rimopu10/carro/render/salida/modelo-completo.png

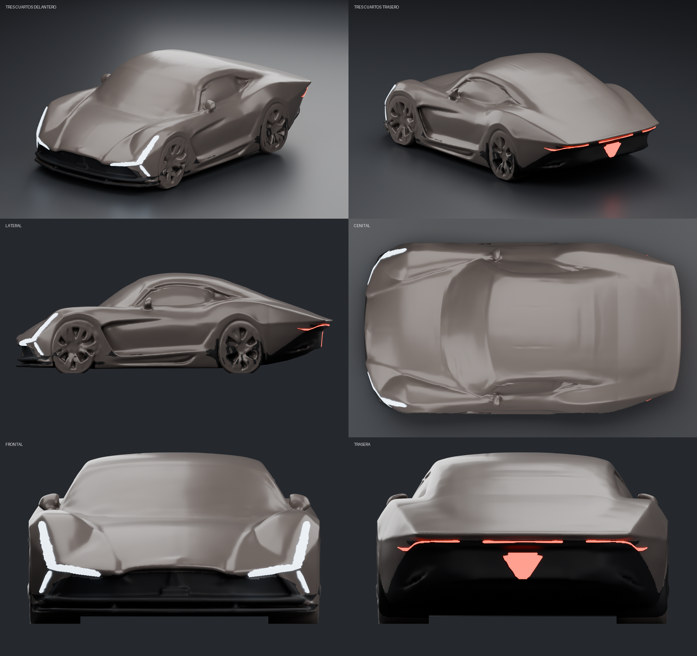
render/salida/modelo-completo.png
