rimopu10/carro/docs/auditoria-cabina/vista-ojos-piloto.png

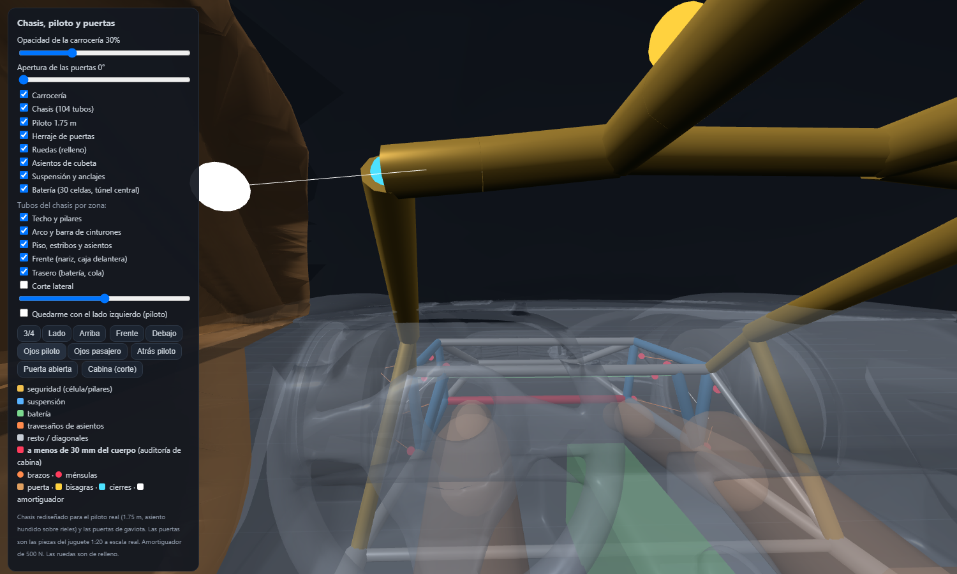
docs/auditoria-cabina/vista-ojos-piloto.png
