rimopu10/carro/docs/espacios-y-cajuela.md

# Espacios libres: frunk, bandeja y maletero

Calculado con `calculos/espacios_libres.py`: interior de la piel de Tripo (cascarón de 12 mm + 20 mm de holgura) menos tubos del chasis, ruedas con su recorrido, brazos,
amortiguadores, cremallera, columna de dirección, pies y piernas de piloto y pasajero, la pila de la batería y la electrónica trasera. Cajas simétricas respecto a z=0.
Los tres espacios se ven en `carro-tripo-chasis-3d.html` (interruptor «Espacios»).

| Espacio | Caja libre | Volumen | Acceso |
|---|---|---|---|
| **Frunk de la nariz** | x 0.00–0.30, y 0.35–0.55, z ±0.30 (0.30 × 0.60 × 0.20 m) | **36 L** | cofre |
| **Bandeja bajo el cofre**, sobre la caja delantera | x 0.36–0.96, y 0.50–0.65, z ±0.25 (0.60 × 0.50 × 0.15 m) | **45 L** | cofre |
| **Maletero** detrás del arco, sobre la electrónica | x 2.24–2.74, y 0.40–0.90, z ±0.35 (0.50 × 0.70 × 0.50 m) | **175 L** | clamshell trasero |
| Hueco bajo el tablero entre las piernas | x 0.50–1.00, y 0.10–0.45, z ±0.20 | 70 L | sólo desde la cabina: no se usa |

**Por qué lo de adelante es chico:** el eje delantero está a 0.55 m de la punta (voladizo corto), las torres de suspensión, la cremallera y la pedalera ocupan la caja entre el
mamparo y el tablero, y el cono de la nariz es la zona de deformación. No es espacio desperdiciado: es el precio de un carro de 2.13 m de batalla con motor y batería
al centro-atrás. El grueso de la carga va **atrás**.

## Reparto propuesto (estilo Porsche: servicios adelante, equipaje atrás)
**Frunk de la nariz (36 L):** depósito del lavaparabrisas (3–4 L), toma de carga con su cable (~3 L), compresor de aire y kit de pinchazo, banda de remolque. Objetos ligeros:
es la zona de deformación, no se pone nada pesado ni rígido.
**Bandeja bajo el cofre (45 L, plana de 15 cm):** motor y varillaje de limpiaparabrisas (junto al cowl, x≈0.95), depósitos de líquido de frenos (junto a los cilindros del pedal),
triángulo de emergencia, botiquín, herramienta. Todo atornillado a una charola de aluminio con tapa de servicio.
**Maletero (175 L):** equipaje (dos maletas de cabina), cascos, gatos. Queda sobre la electrónica de potencia (y < 0.40), con piso de aluminio y una división contra los cables.

Masa de estos servicios ≈ 12 kg (agua 4, cable y compresor 5, herramienta 3): efecto en el reparto despreciable (<0.2 puntos).

## Pendiente
* Dibujar la tapa del cofre y sus bisagras (hoy el cofre es piel fija en el modelo) y el clamshell trasero.
* Revisar con el proveedor el tamaño real del depósito y del motor del limpiaparabrisas.
* Si se quiere más frunk: un carro con el voladizo delantero 10 cm más largo daría ~+25 L; no se recomienda sin rehacer la carrocería de Tripo.
