rimopu10/carro/calculos/carro3d-jaula.png

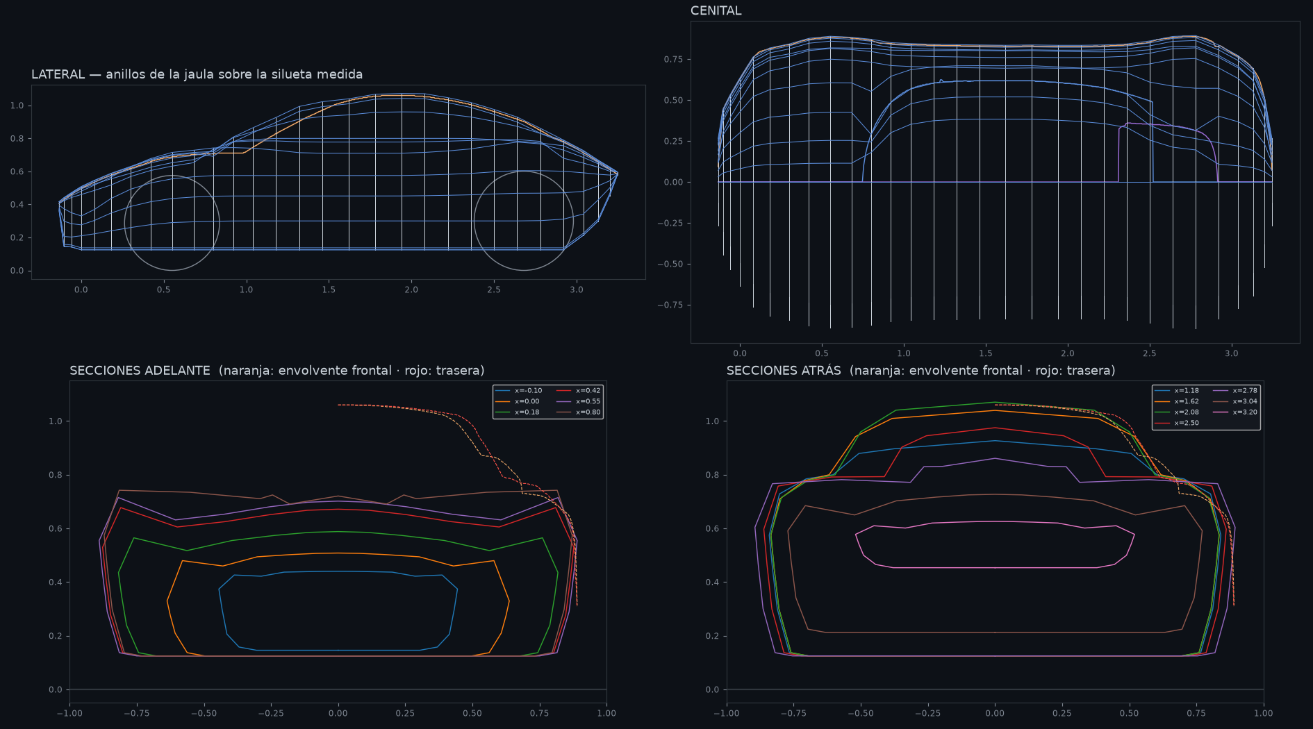
calculos/carro3d-jaula.png
