rimopu10/carro/calculos/carroceria-proporciones.png

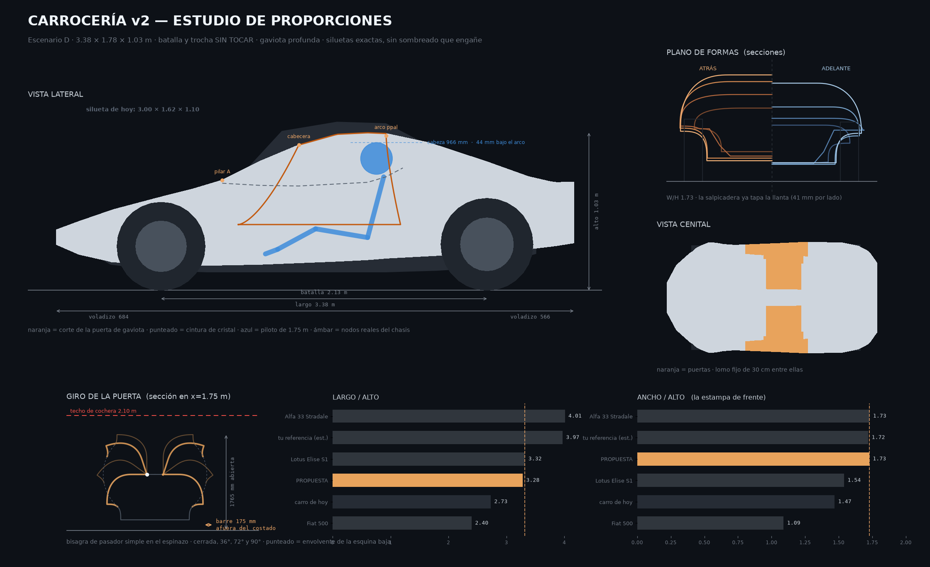
calculos/carroceria-proporciones.png
