rimopu10/carro/calculos/chasis-generativo-vs-tubos.png

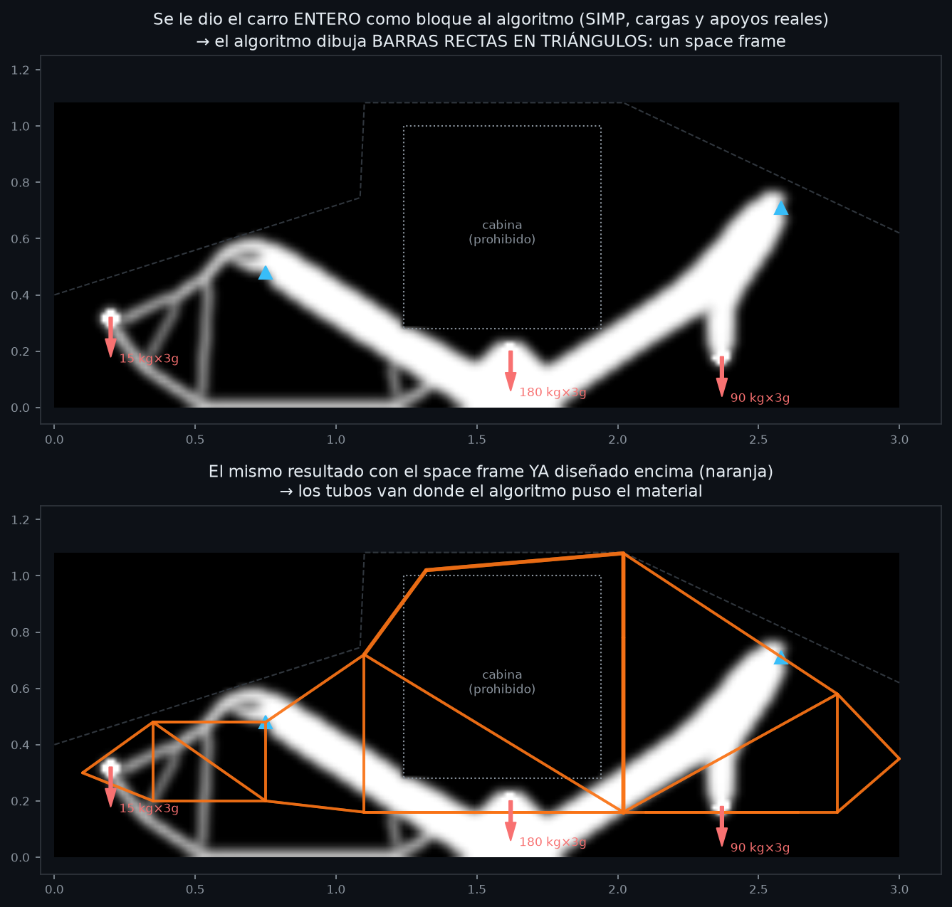
calculos/chasis-generativo-vs-tubos.png
