rimopu10/carro/calculos/direccion.png

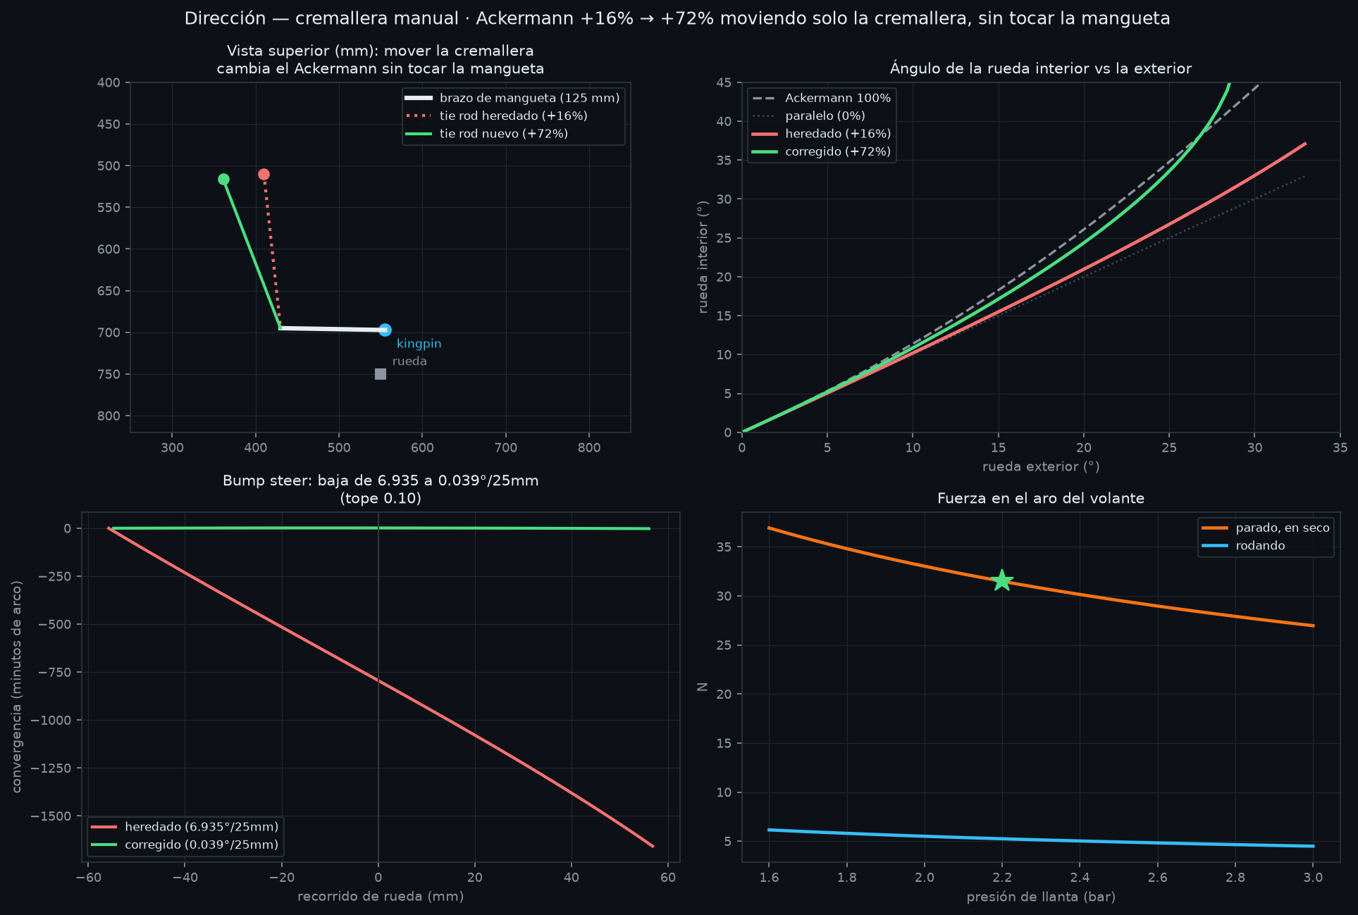
calculos/direccion.png
