rimopu10/carro/calculos/frenos.png

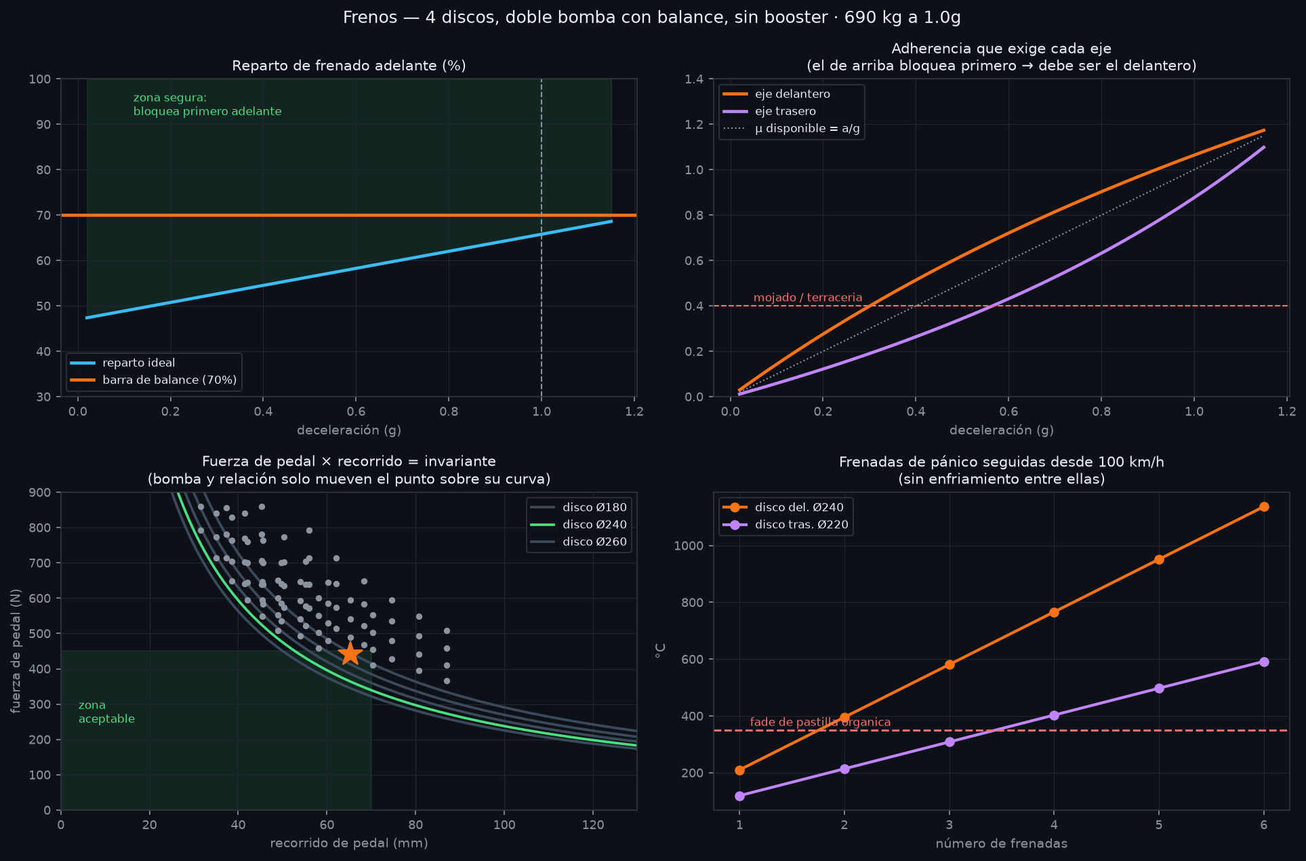
calculos/frenos.png
