rimopu10/carro/calculos/optimizacion-chasis.png

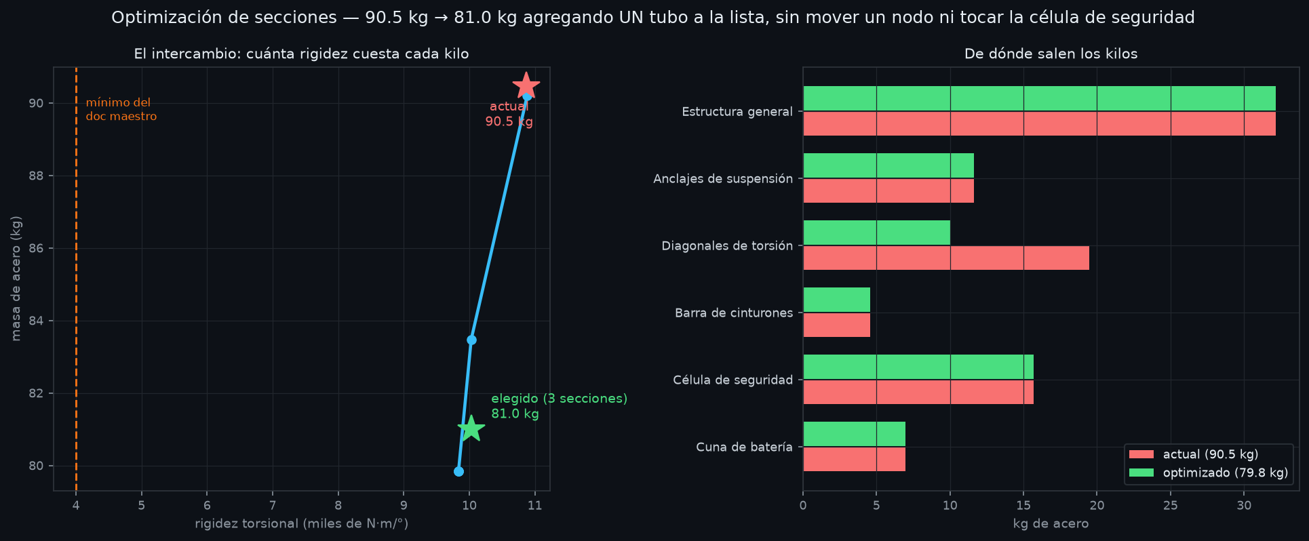
calculos/optimizacion-chasis.png
