rimopu10/carro/calculos/placa-torque.png

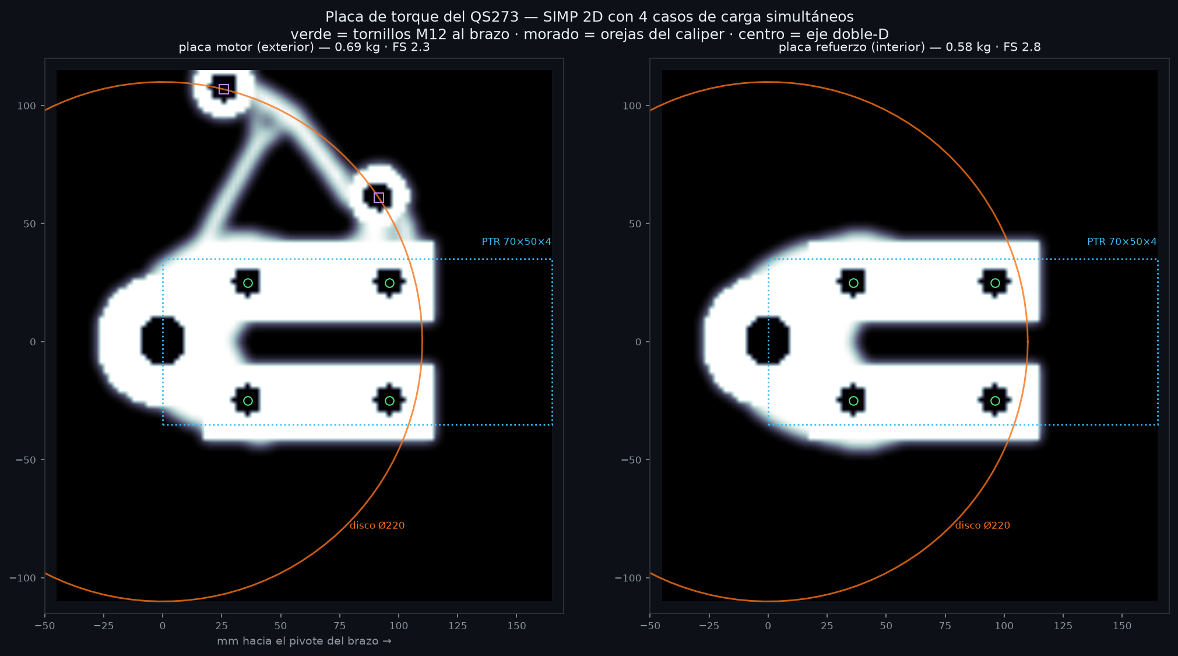
calculos/placa-torque.png
