rimopu10/carro/calculos/suspension-delantera.png

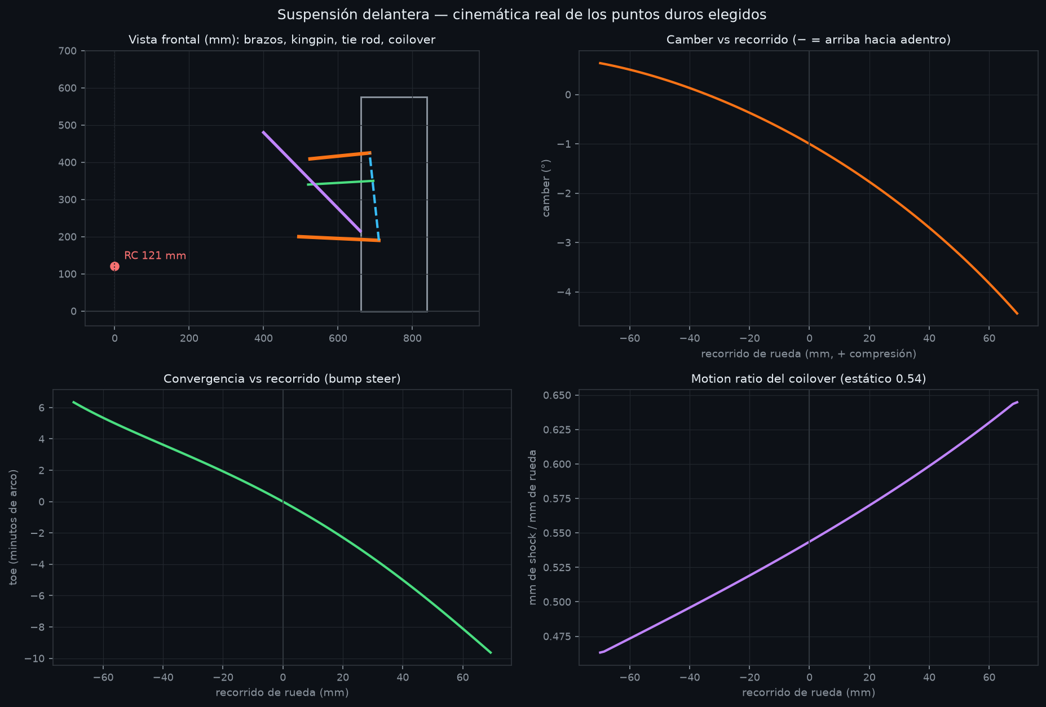
calculos/suspension-delantera.png
