rimopu10/carro/calculos/suspension-trasera.png

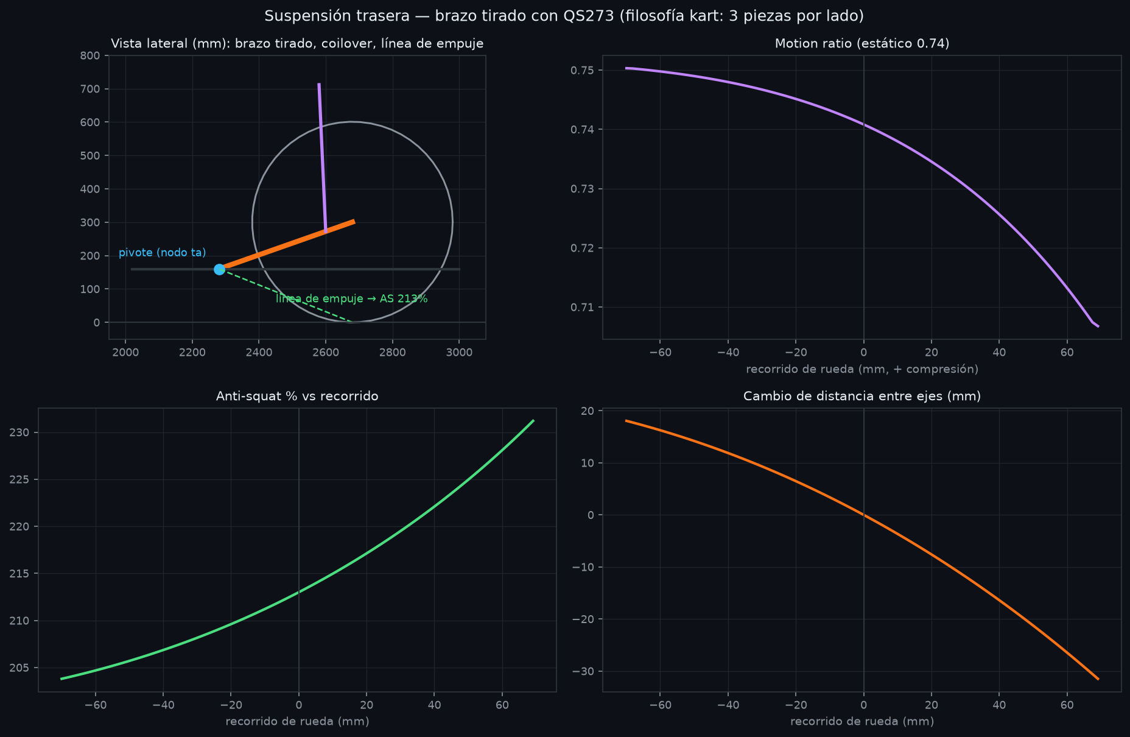
calculos/suspension-trasera.png
