rimopu10/carro/docs/auditoria-cabina/cabina-tubos-vs-cuerpo.png

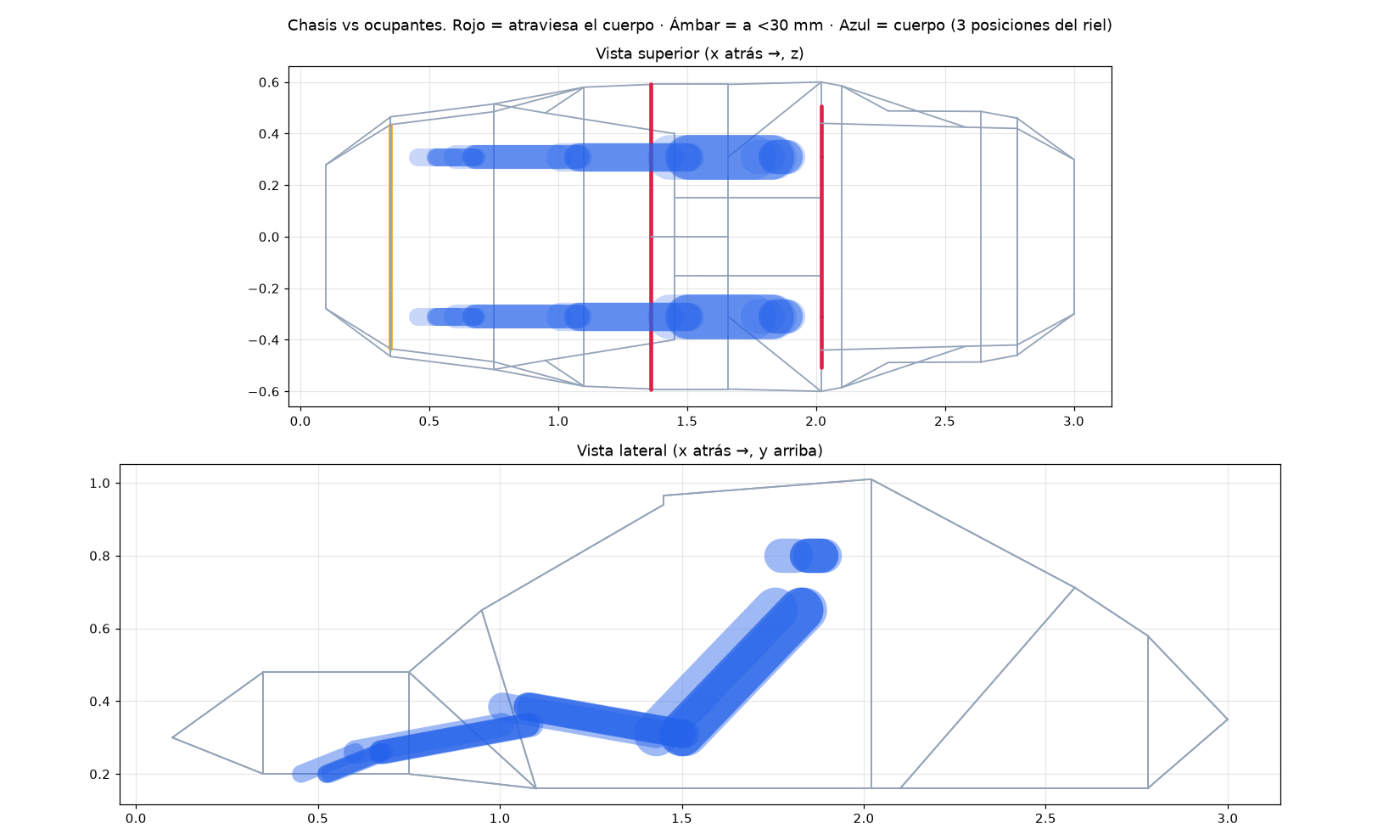
docs/auditoria-cabina/cabina-tubos-vs-cuerpo.png
