rimopu10/carro/docs/auditoria-cabina/vista-arriba-sin-techo.png

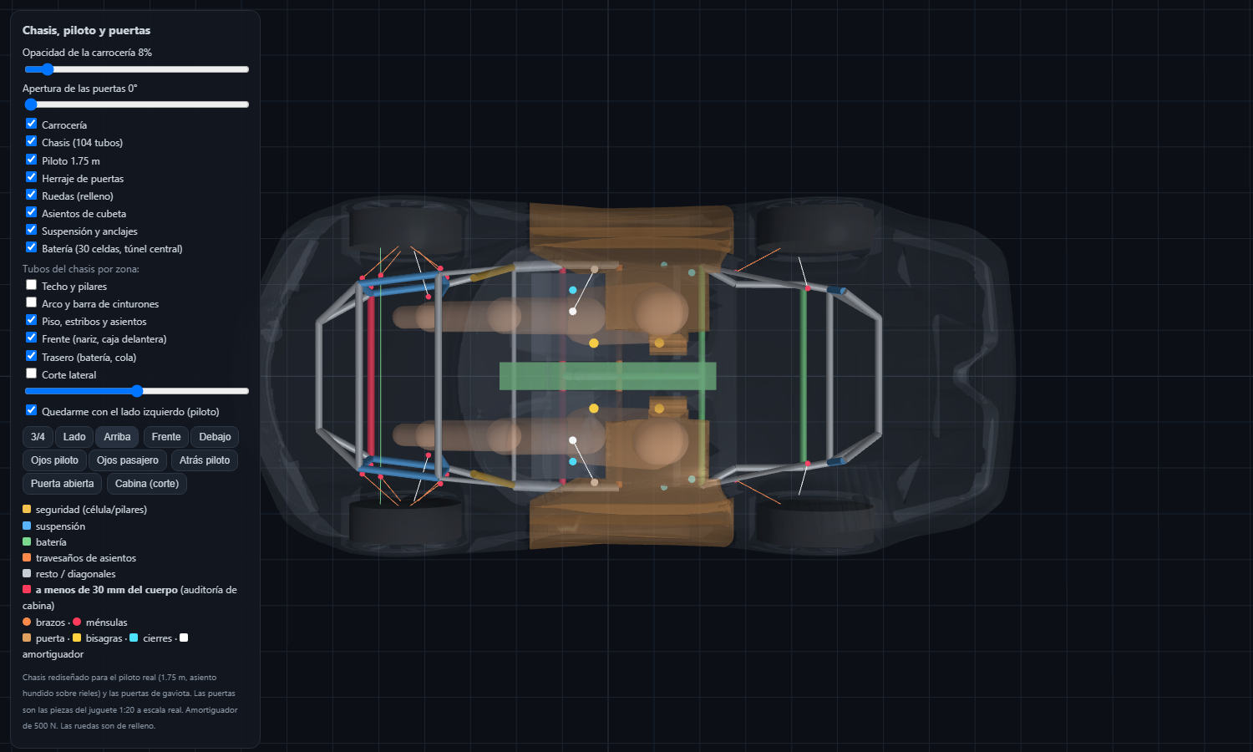
docs/auditoria-cabina/vista-arriba-sin-techo.png
