rimopu10/carro/docs/auditoria-cabina/vista-cabina-corte.png

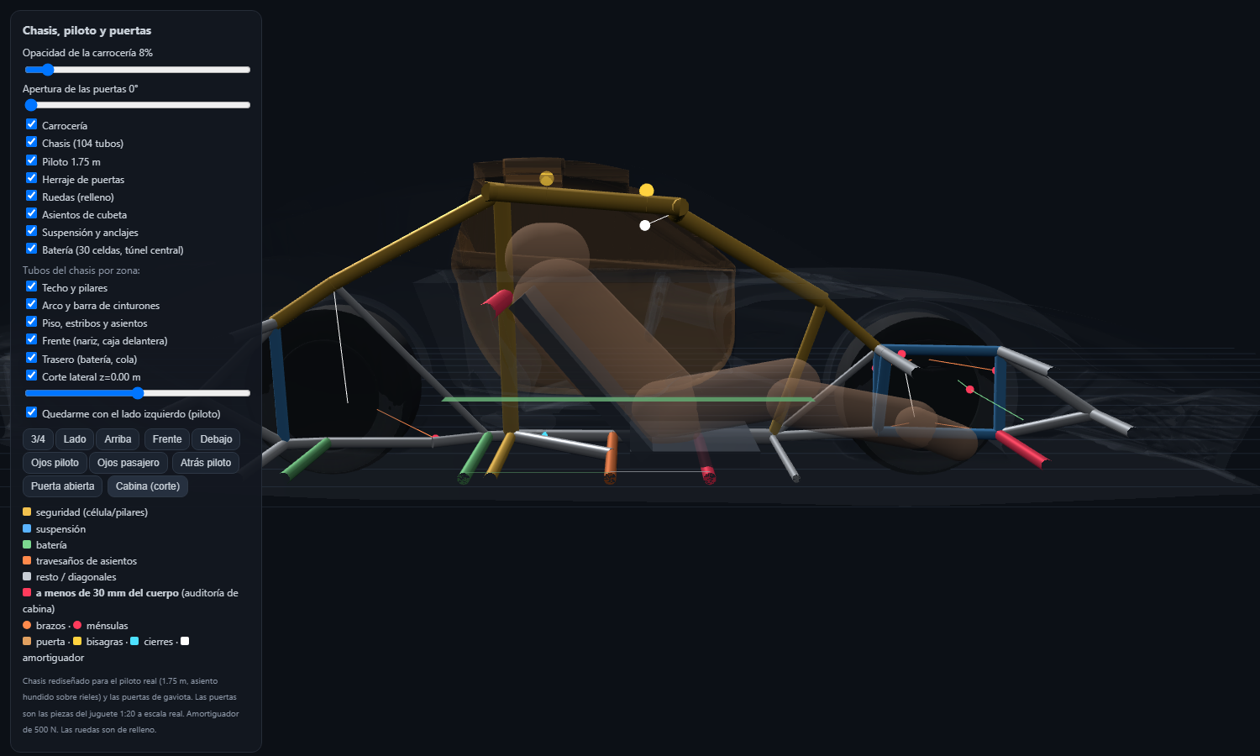
docs/auditoria-cabina/vista-cabina-corte.png
