rimopu10/carro/docs/auditoria-cabina/vista-espacios-lado.png

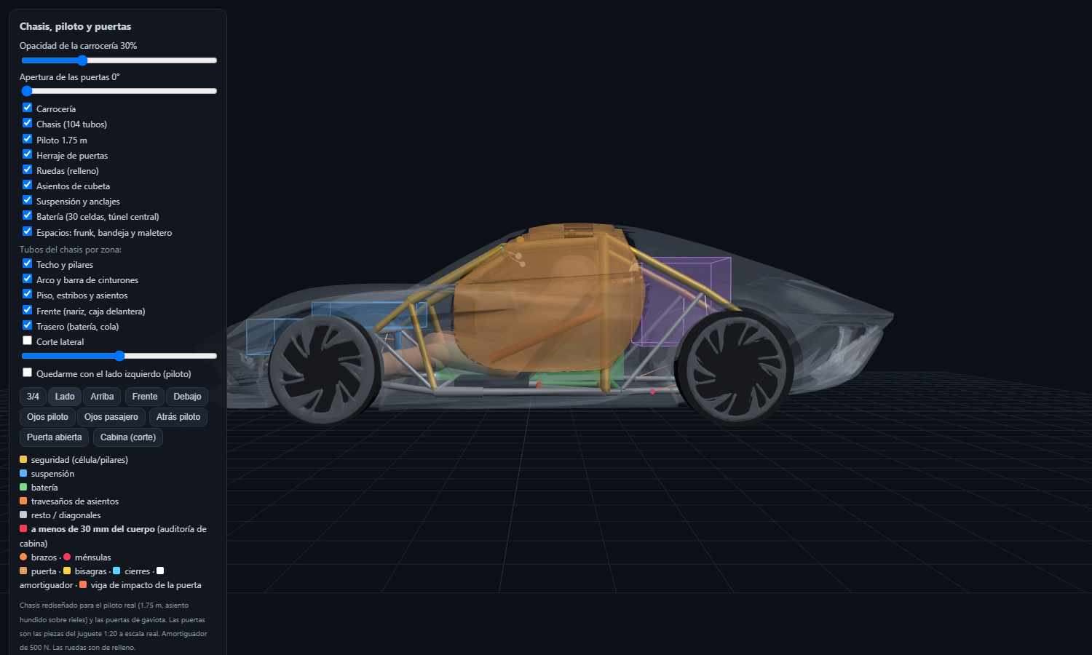
docs/auditoria-cabina/vista-espacios-lado.png
