rimopu10/carro/docs/auditoria-cabina/vista-general.png

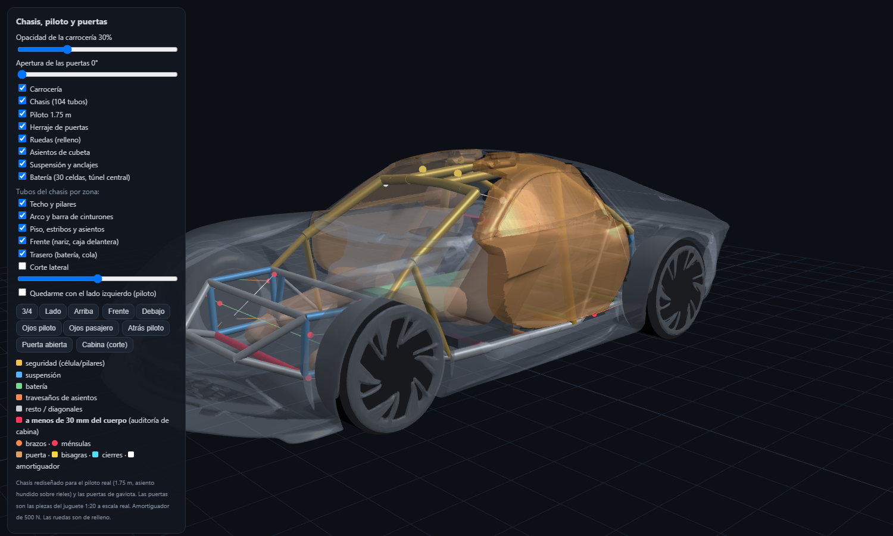
docs/auditoria-cabina/vista-general.png
