rimopu10/carro/docs/auditoria-cabina/vista-ojos-pasajero.png

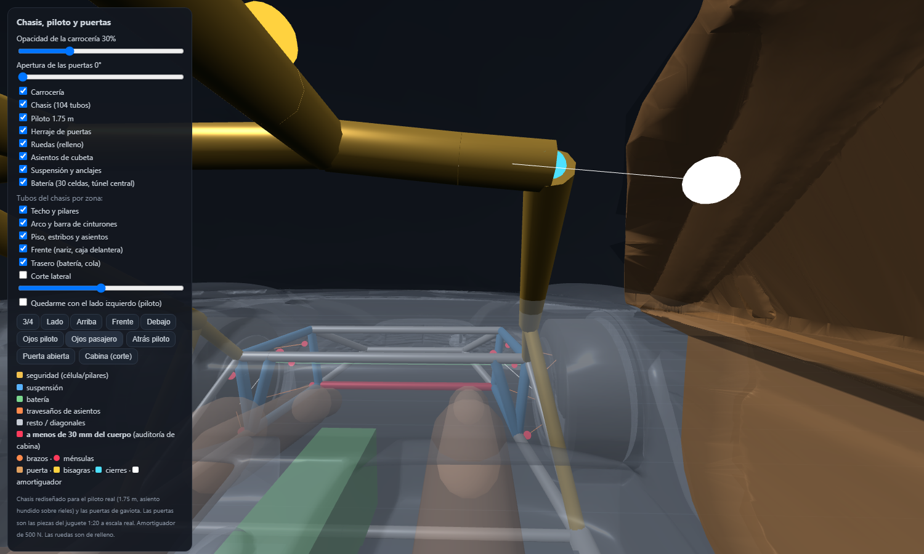
docs/auditoria-cabina/vista-ojos-pasajero.png
