rimopu10/carro/docs/auditoria-cabina/vista-puerta-abierta.png

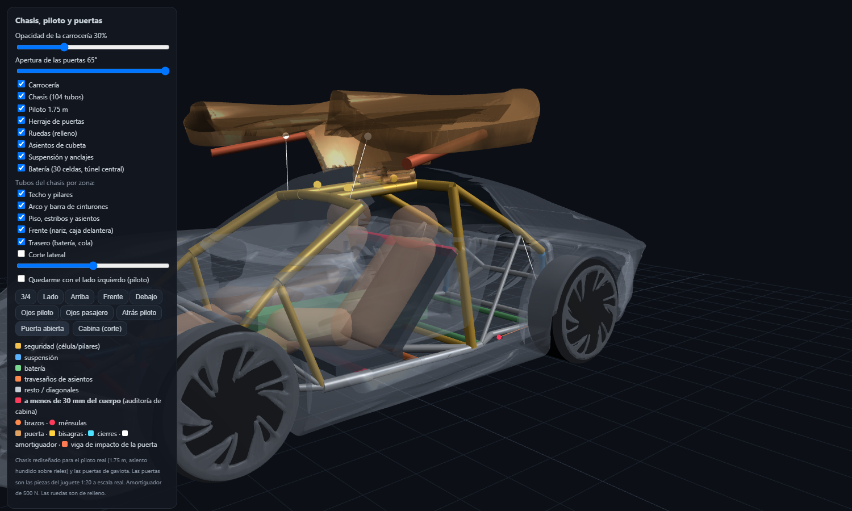
docs/auditoria-cabina/vista-puerta-abierta.png
