rimopu10/carro/ref/_crop_lateral.png

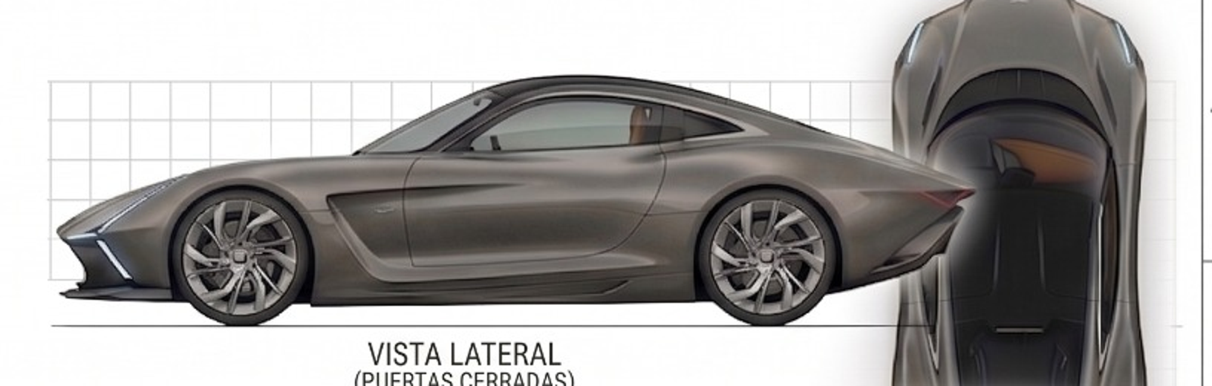
ref/_crop_lateral.png
