rimopu10/carro/ref/_rejilla.png

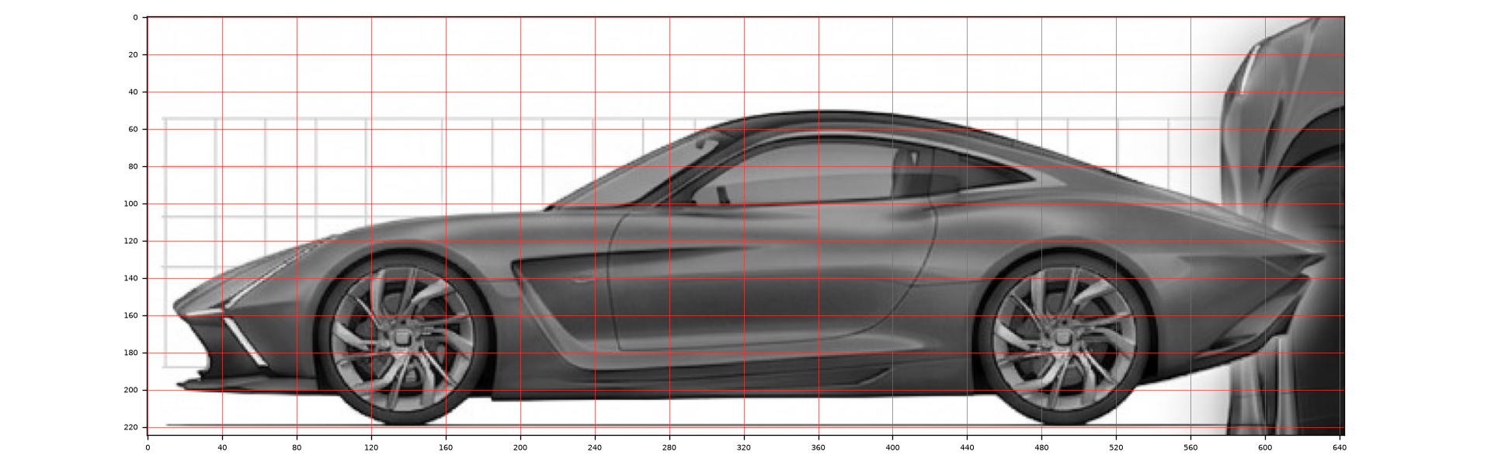
ref/_rejilla.png
