rimopu10/carro/ref/_tres_vistas.png

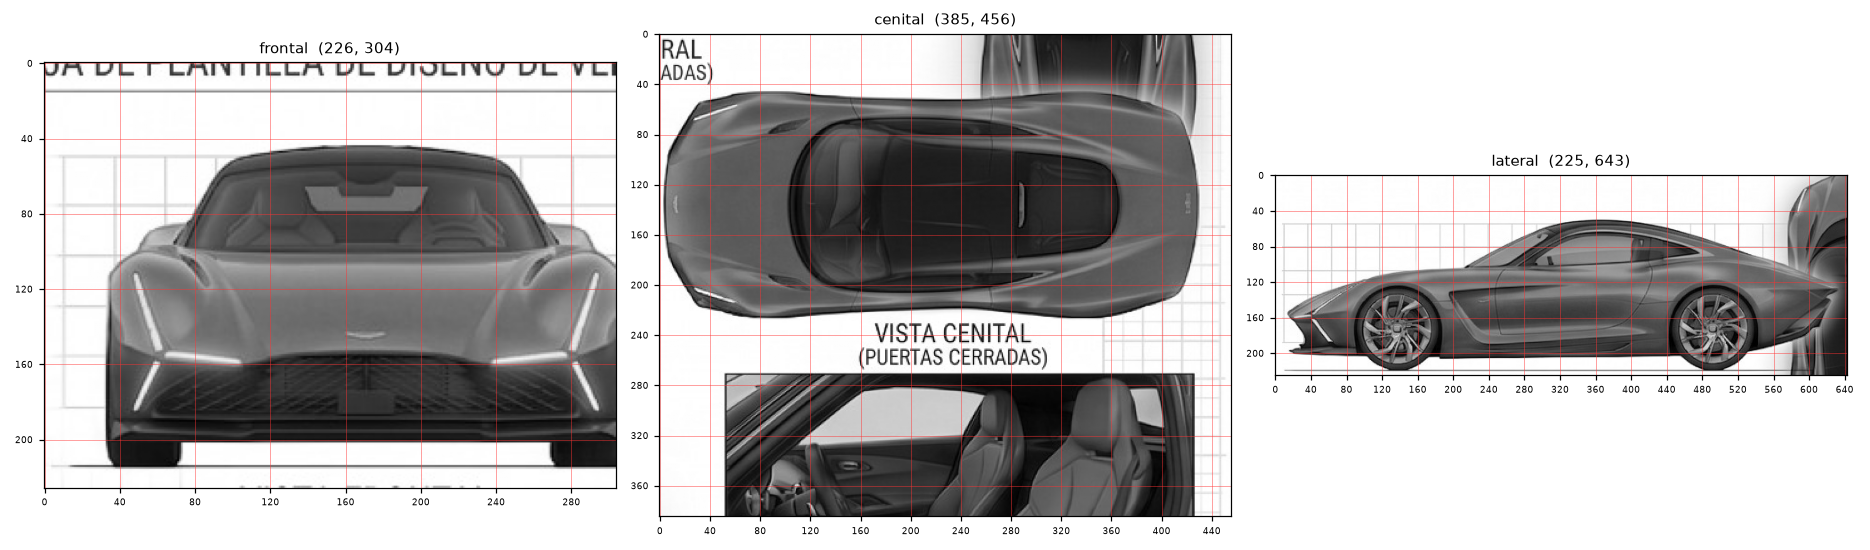
ref/_tres_vistas.png
