rimopu10/carro/ref/blueprint-andamio.png

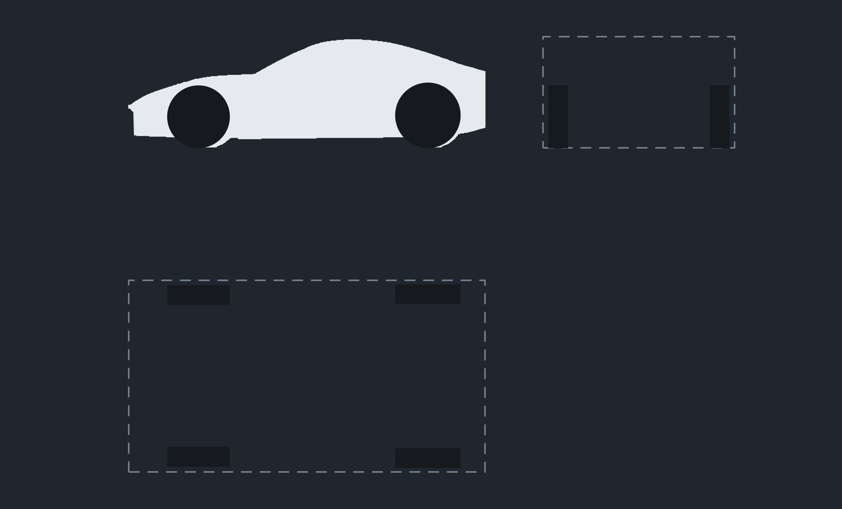
ref/blueprint-andamio.png
