rimopu10/carro/ref/blueprint-limpio.png

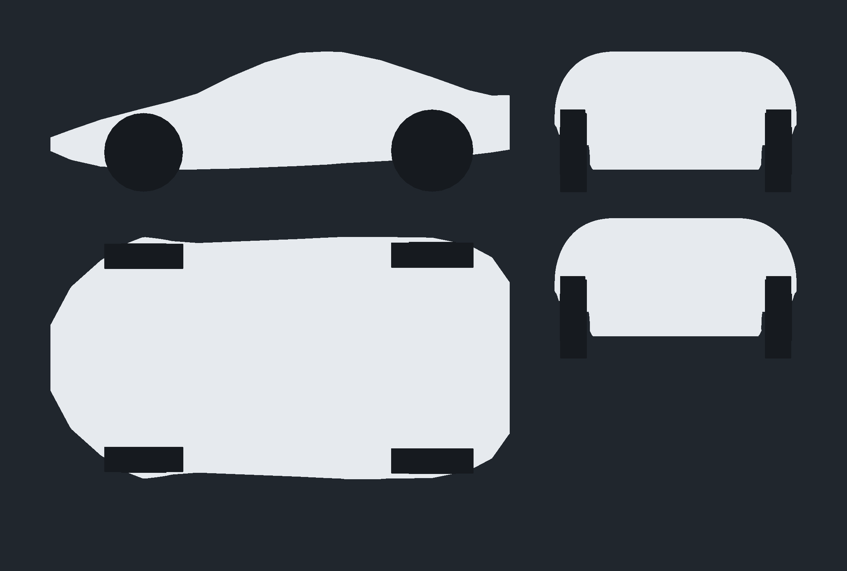
ref/blueprint-limpio.png
