rimopu10/carro/ref/blueprint-tecnico.png

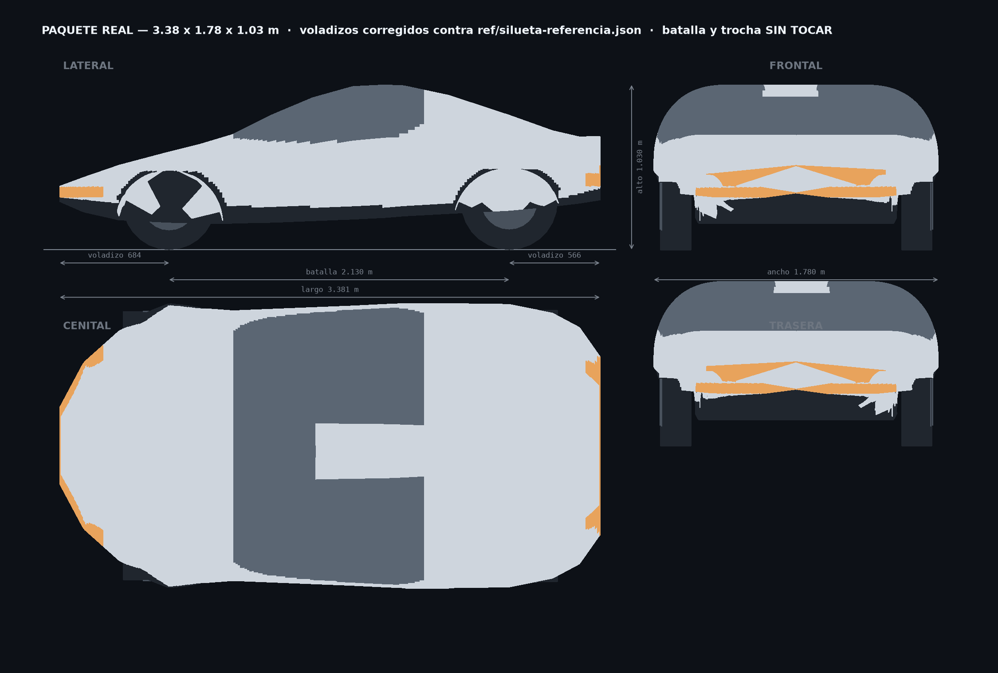
ref/blueprint-tecnico.png
