rimopu10/carro/ref/gemini/_check.png

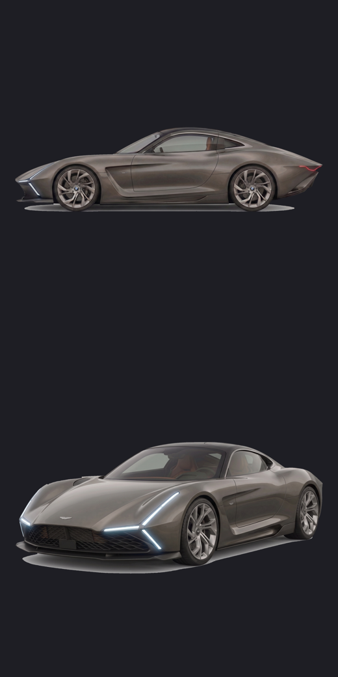
ref/gemini/_check.png
