rimopu10/carro/ref/gemini/_hoja.png

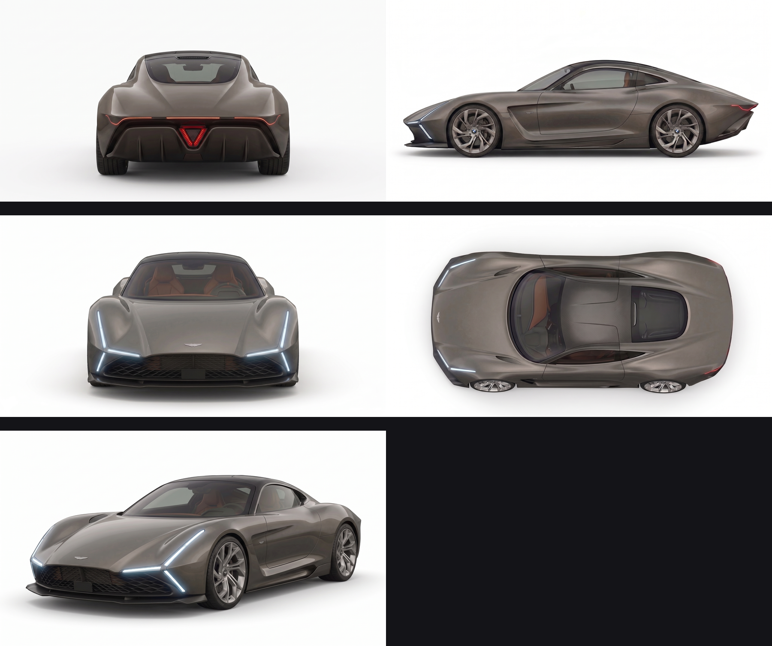
ref/gemini/_hoja.png
