rimopu10/carro/ref/gemini/g1.jpg

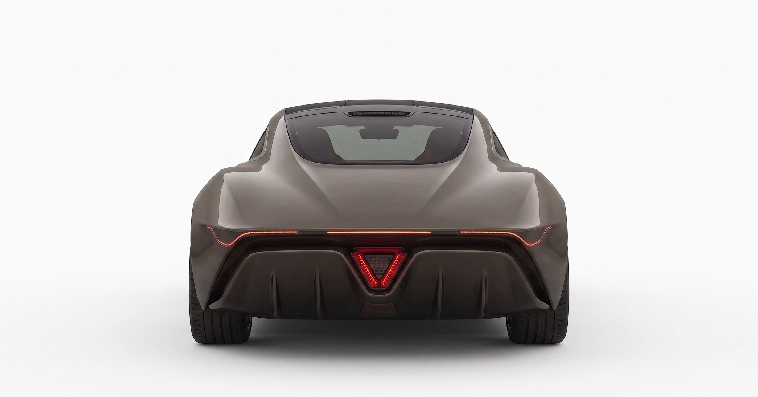
ref/gemini/g1.jpg
