rimopu10/carro/ref/gemini/g2.jpg

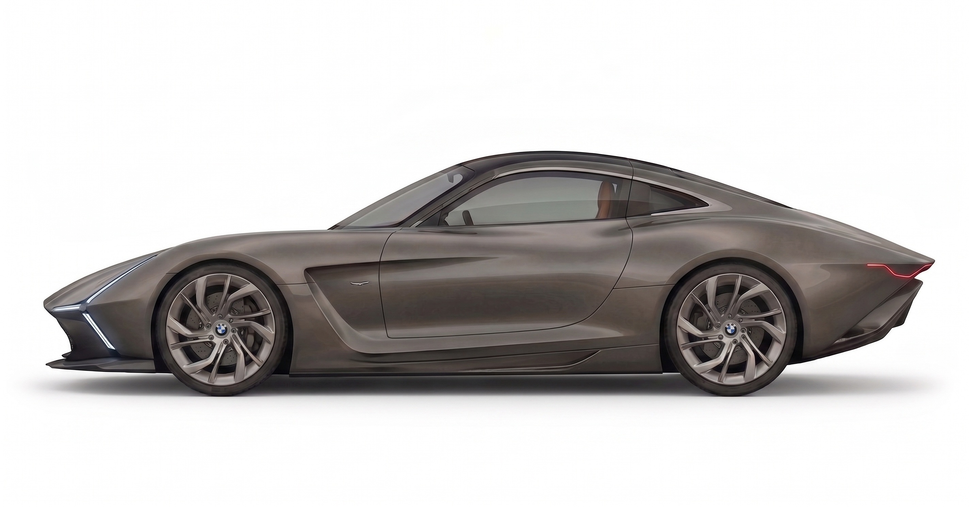
ref/gemini/g2.jpg
