rimopu10/carro/ref/gemini/g3.jpg

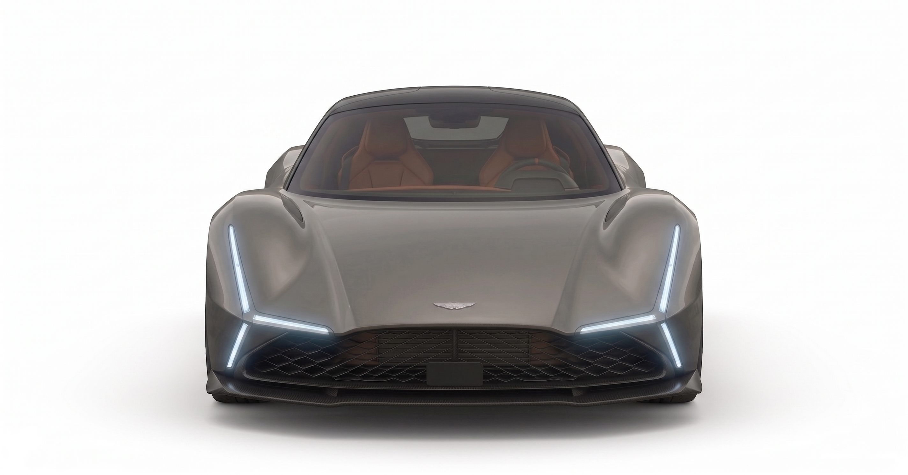
ref/gemini/g3.jpg
