rimopu10/carro/ref/gemini/g4.jpg

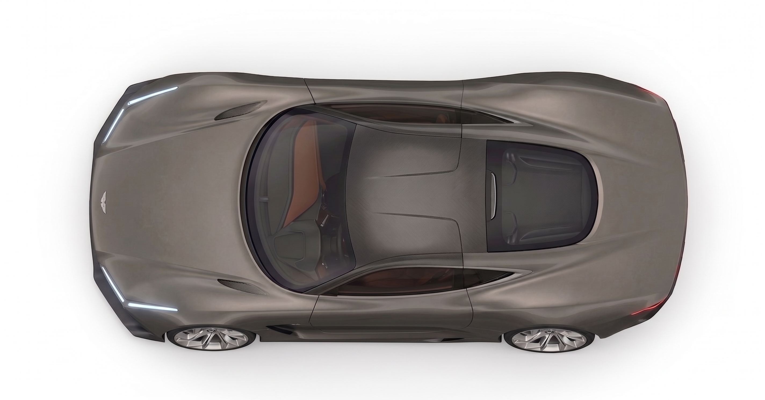
ref/gemini/g4.jpg
