rimopu10/carro/ref/gemini/g5.jpg

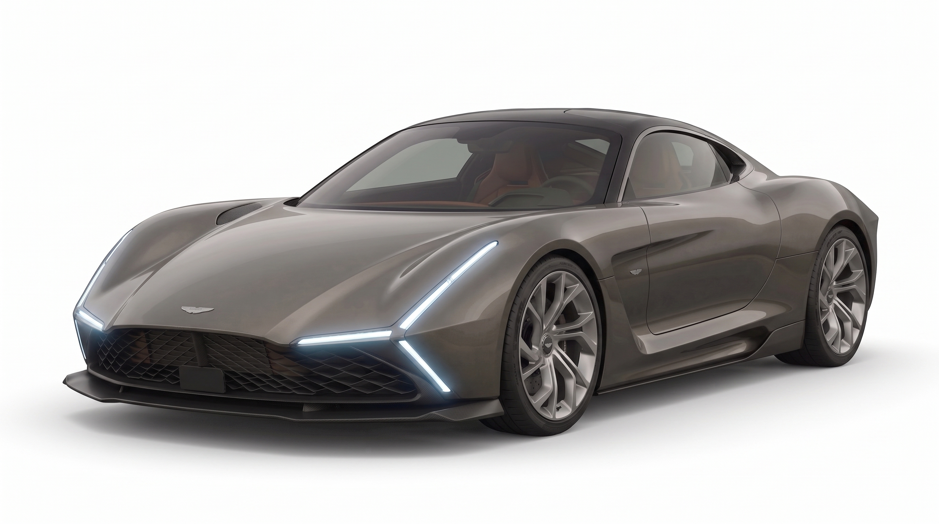
ref/gemini/g5.jpg
