rimopu10/carro/ref/gemini/ia-cenital.png

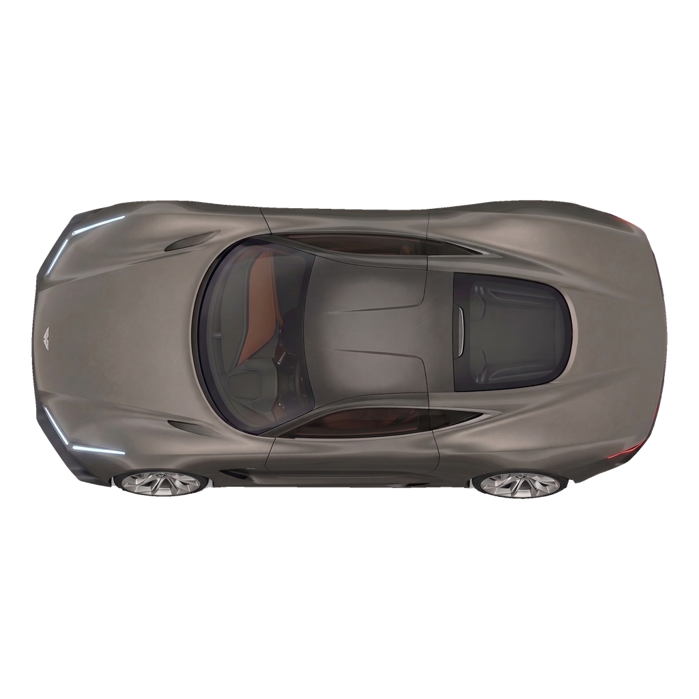
ref/gemini/ia-cenital.png
