rimopu10/carro/ref/gemini/ia-frontal.png

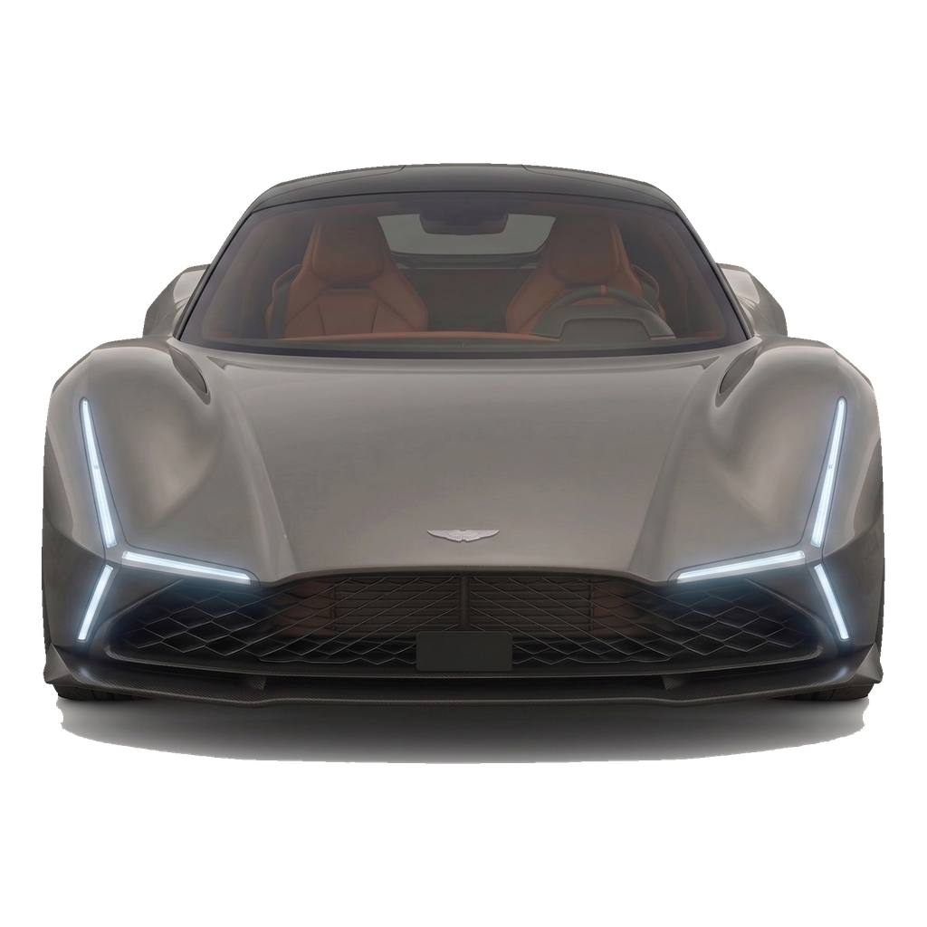
ref/gemini/ia-frontal.png
