rimopu10/carro/ref/gemini/ia-lateral-espejo.png

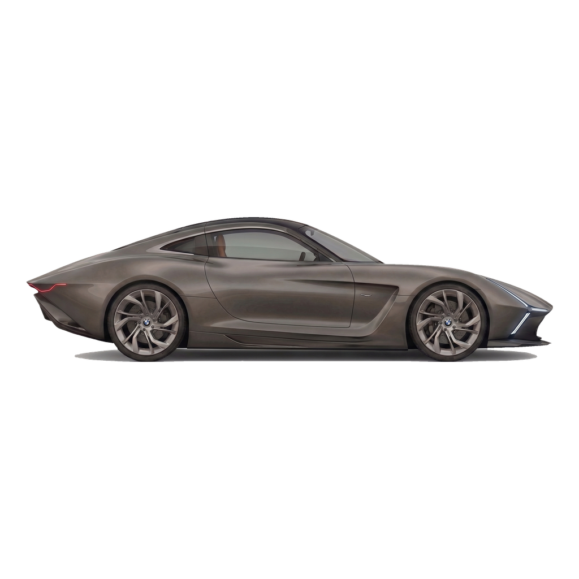
ref/gemini/ia-lateral-espejo.png
