rimopu10/carro/ref/gemini/ia-trasera.png

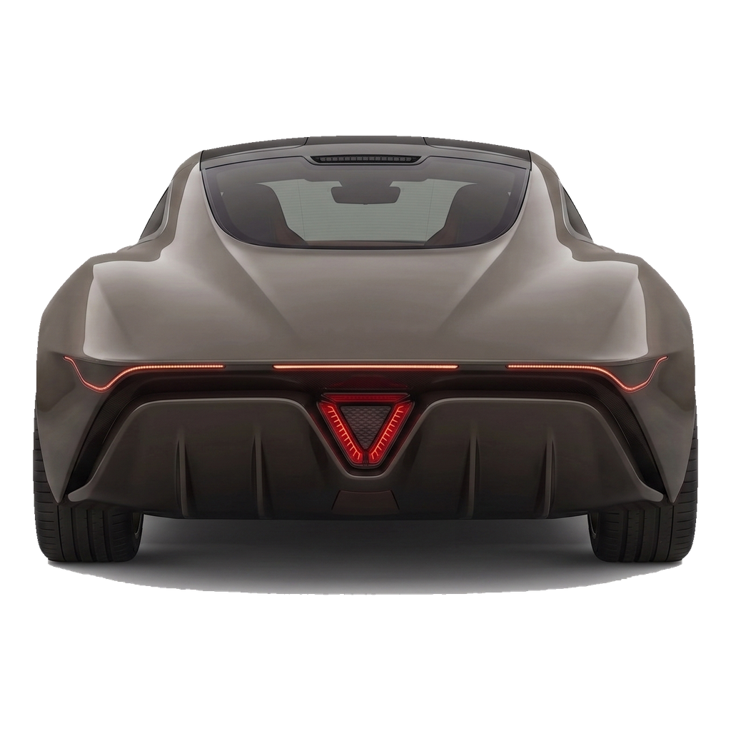
ref/gemini/ia-trasera.png
