rimopu10/carro/ref/gemini/ia-tres_cuartos.png

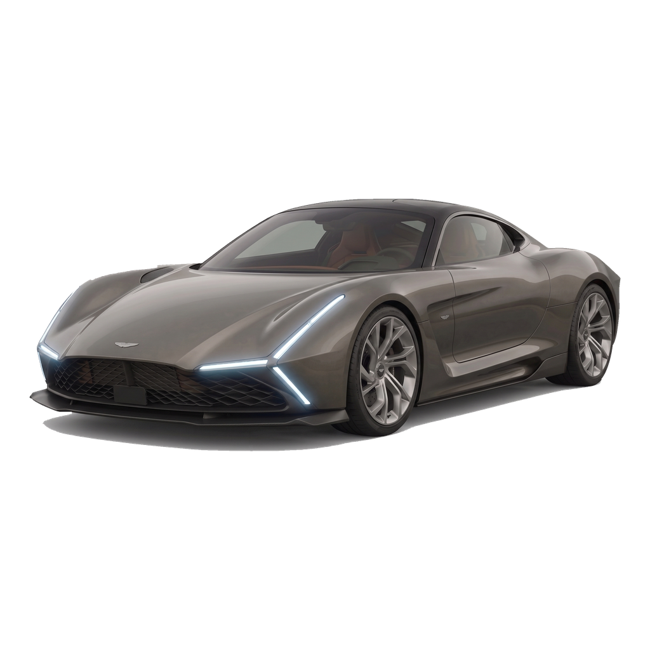
ref/gemini/ia-tres_cuartos.png
