rimopu10/carro/ref/ia-cenital.png

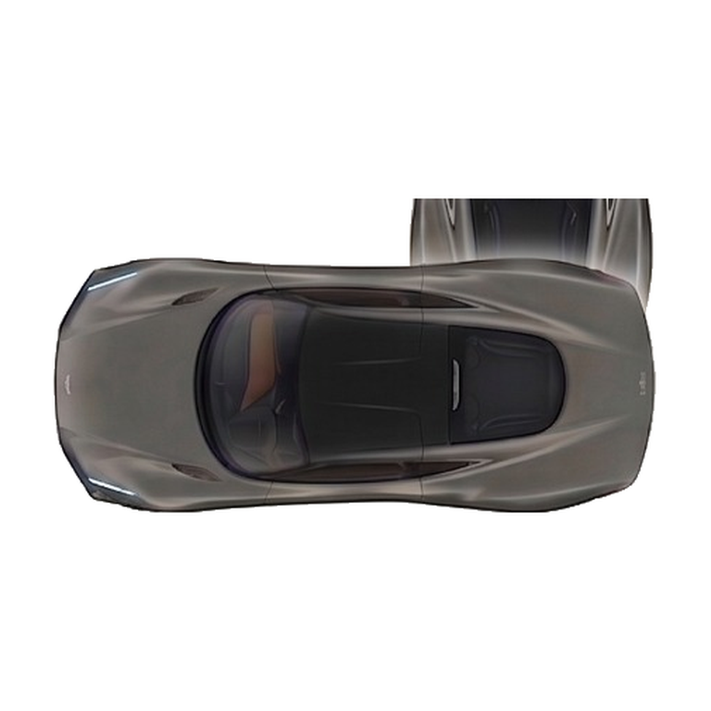
ref/ia-cenital.png
