rimopu10/carro/ref/ia-frontal.png

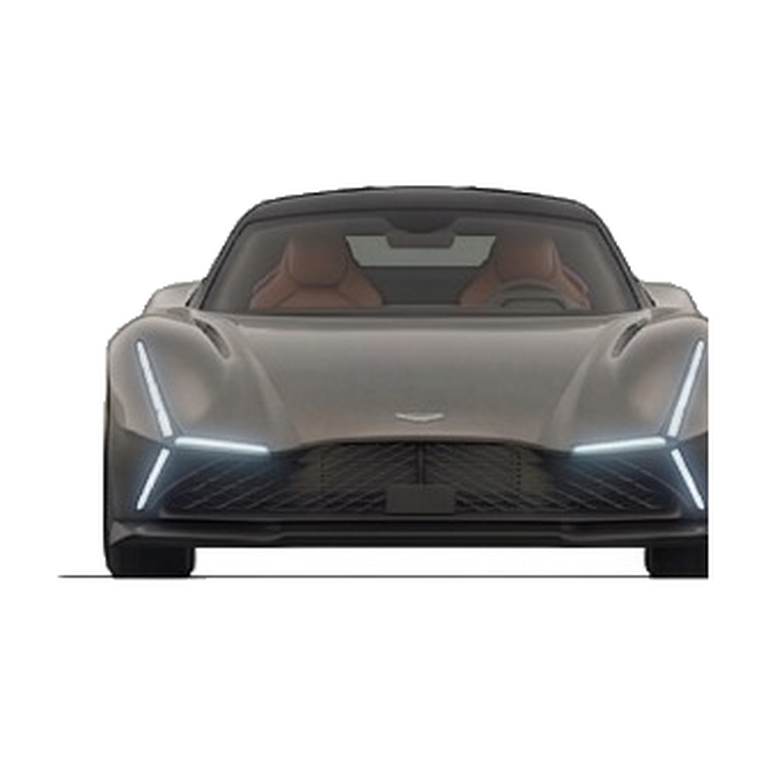
ref/ia-frontal.png
