rimopu10/carro/ref/ia-lateral-espejo.png

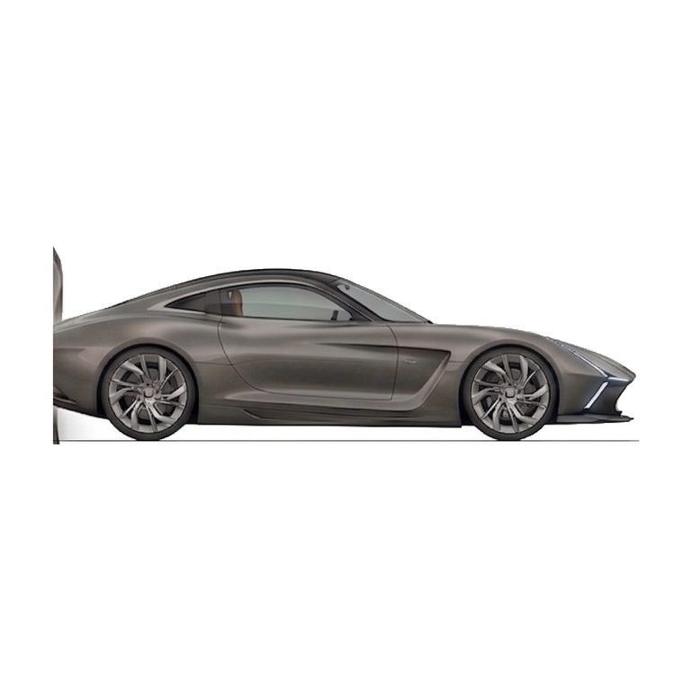
ref/ia-lateral-espejo.png
