rimopu10/carro/ref/ia-lateral.png

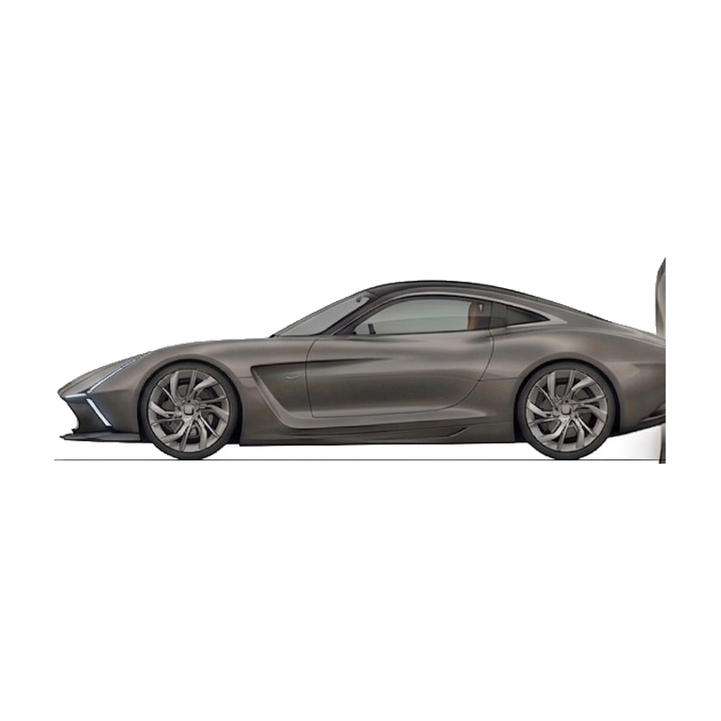
ref/ia-lateral.png
