rimopu10/carro/ref/ia-trasera.png

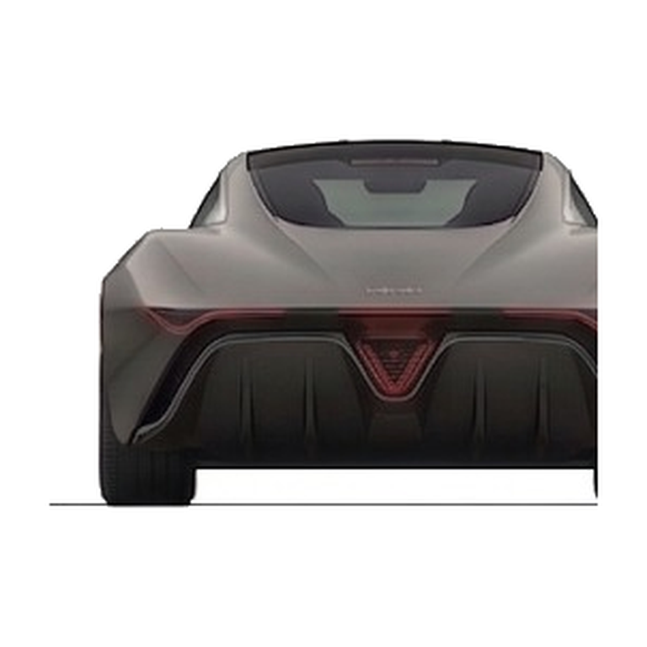
ref/ia-trasera.png
