rimopu10/carro/ref/ref-3-4-trasera.jpg

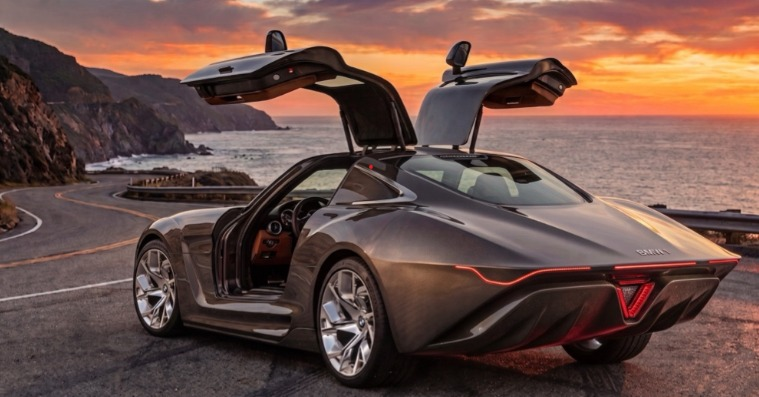
ref/ref-3-4-trasera.jpg
