rimopu10/carro/ref/ref-frontal.jpg

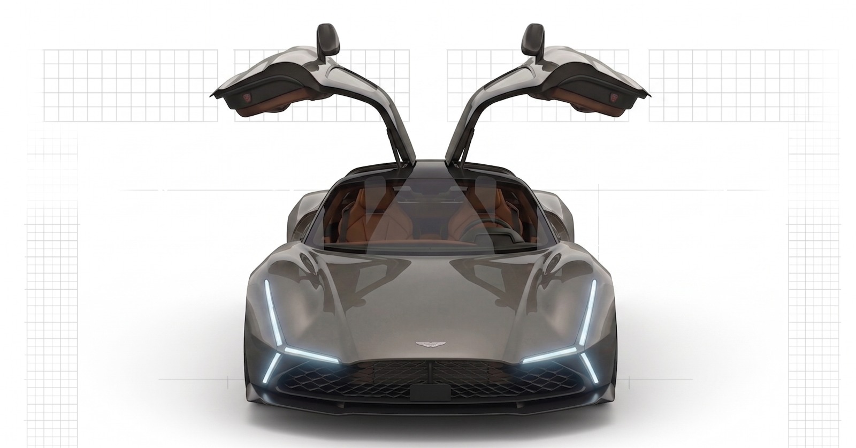
ref/ref-frontal.jpg
