rimopu10/carro/ref/ref-lamina.jpg

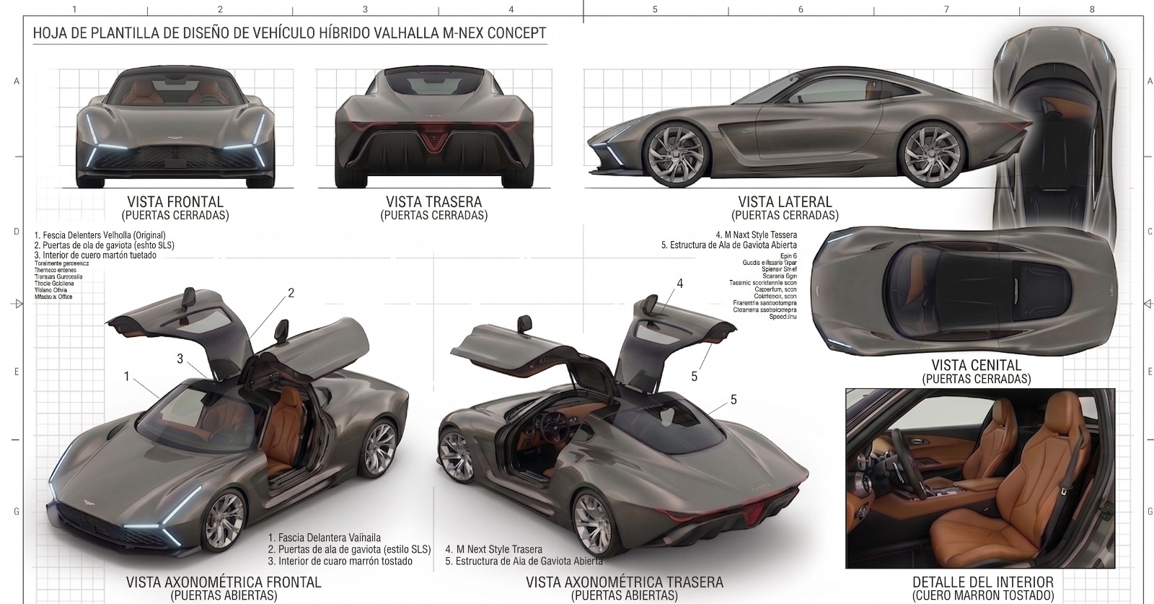
ref/ref-lamina.jpg
