rimopu10/carro/ref/tripo/multivista/back.png

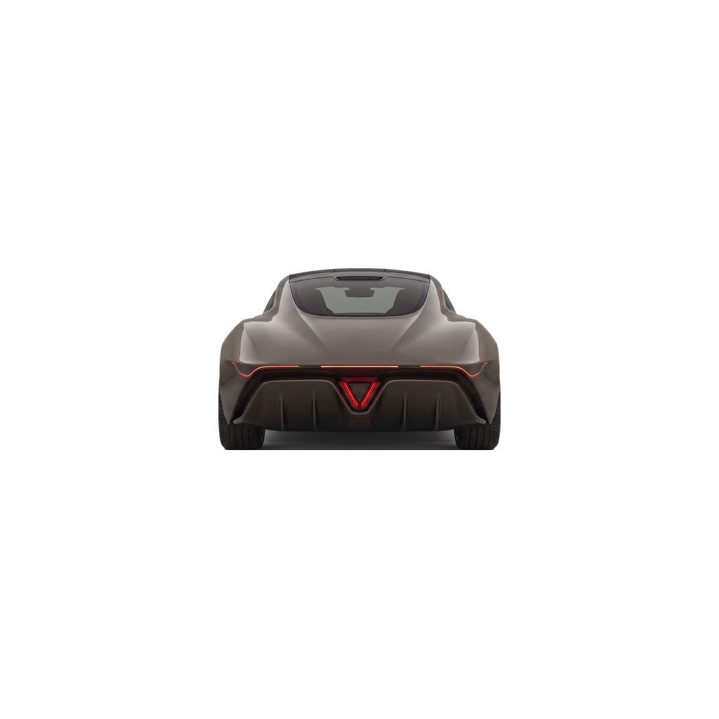
ref/tripo/multivista/back.png
