rimopu10/carro/ref/tripo/multivista/hoja.png

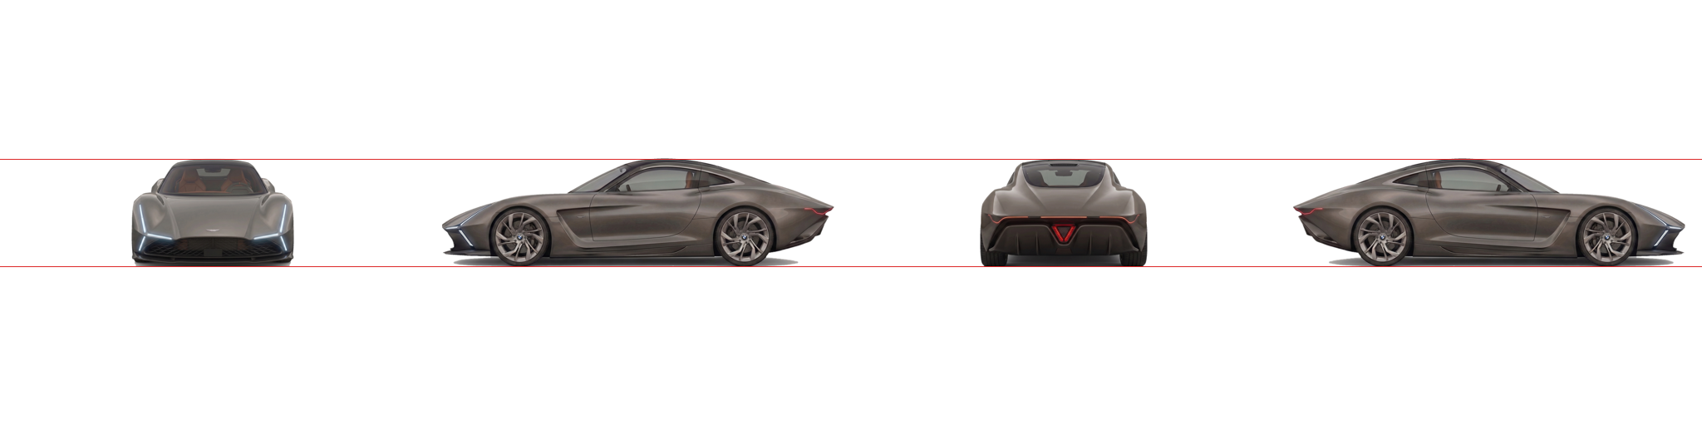
ref/tripo/multivista/hoja.png
