rimopu10/carro/ref/tripo/multivista/left.png

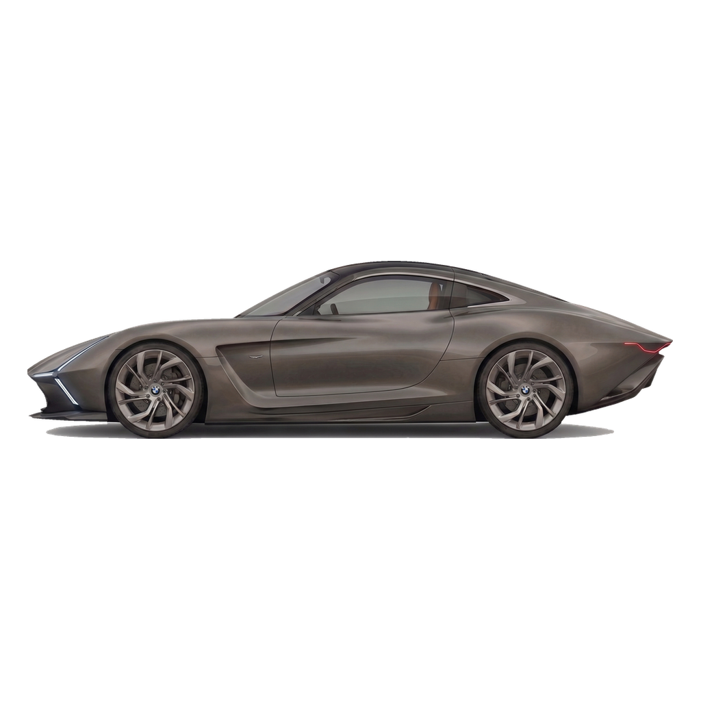
ref/tripo/multivista/left.png
