rimopu10/carro/ref/vista-cenital.png

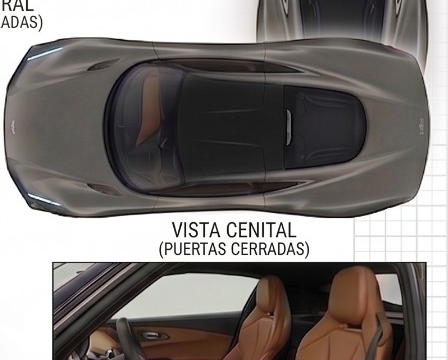
ref/vista-cenital.png
