rimopu10/carro/ref/vista-frontal.png

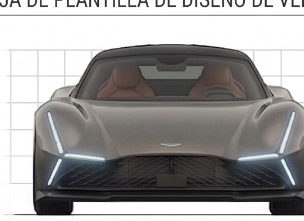
ref/vista-frontal.png
