rimopu10/carro/ref/vista-lateral.png

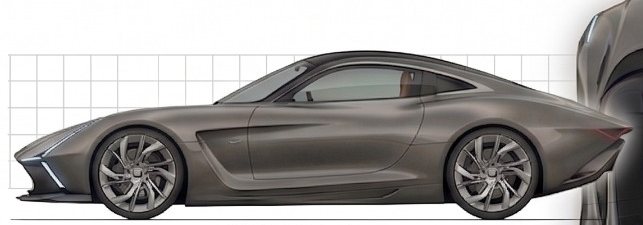
ref/vista-lateral.png
