rimopu10/carro/render/salida/comparacion2.png

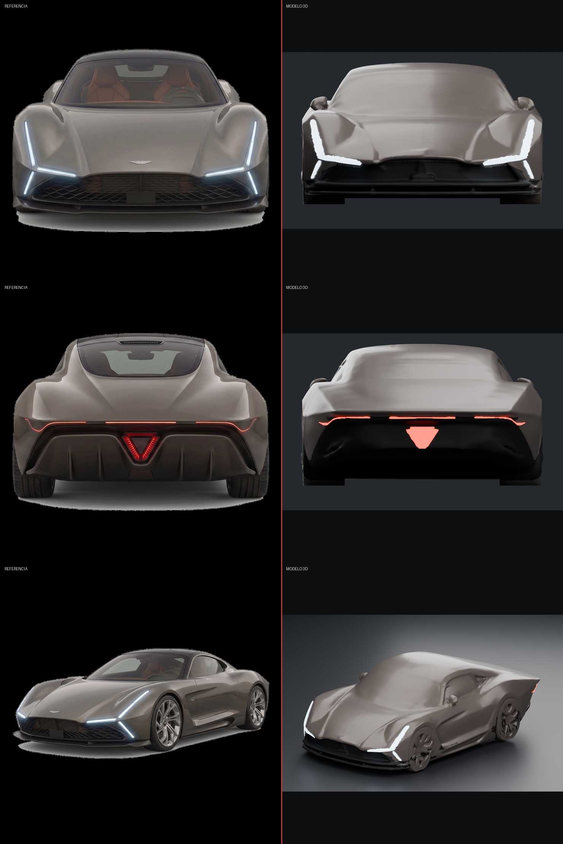
render/salida/comparacion2.png
