rimopu10/carro/render/salida/comparacion.png

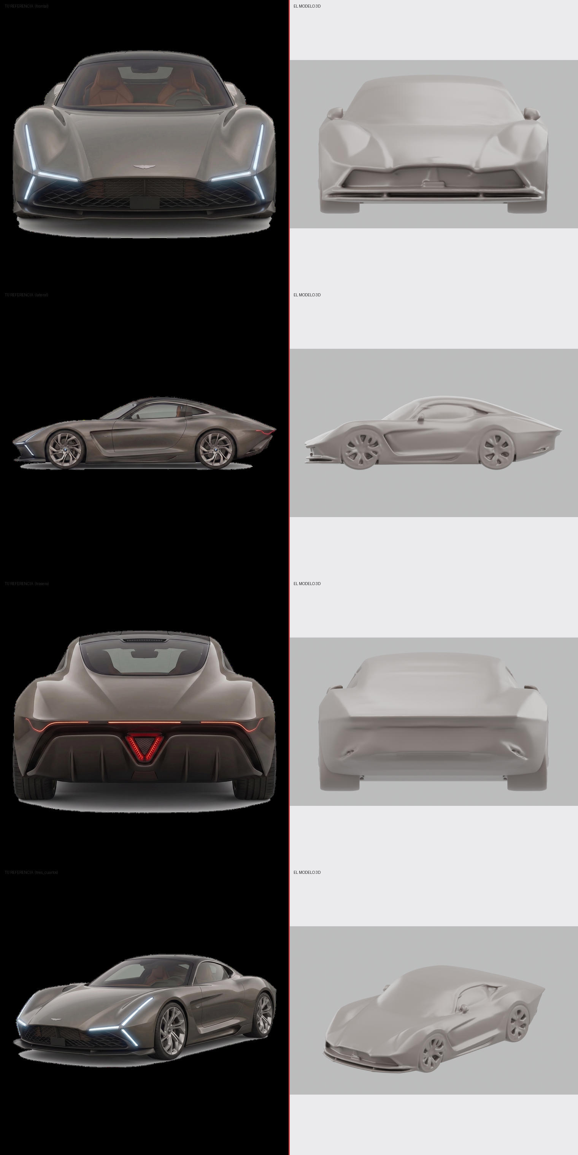
render/salida/comparacion.png
