rimopu10/carro/render/salida/firma-check.png

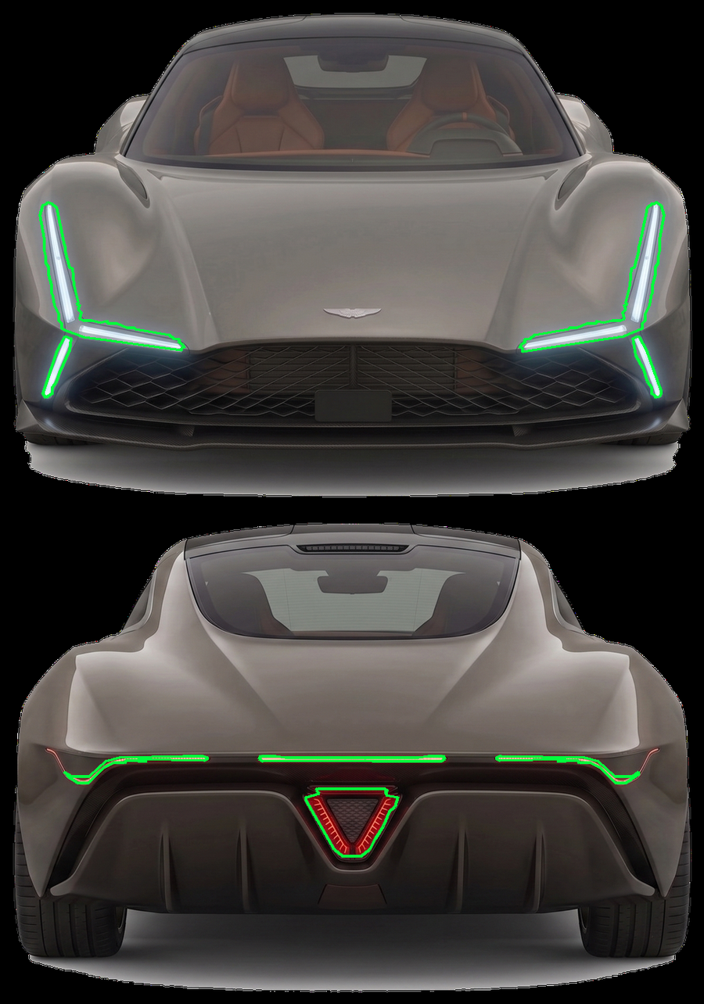
render/salida/firma-check.png
