rimopu10/carro/render/salida/ia-34atras.png

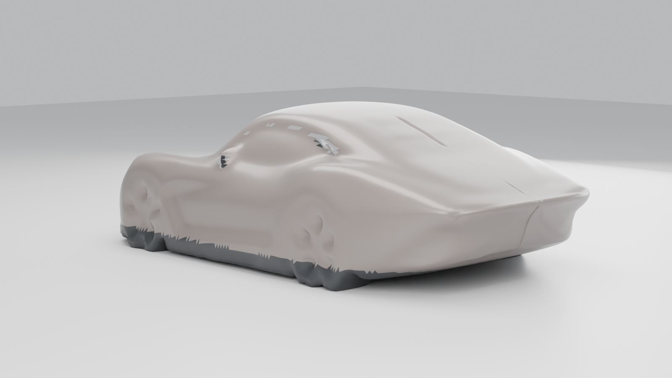
render/salida/ia-34atras.png
