rimopu10/carro/render/salida/ia-34frente.png

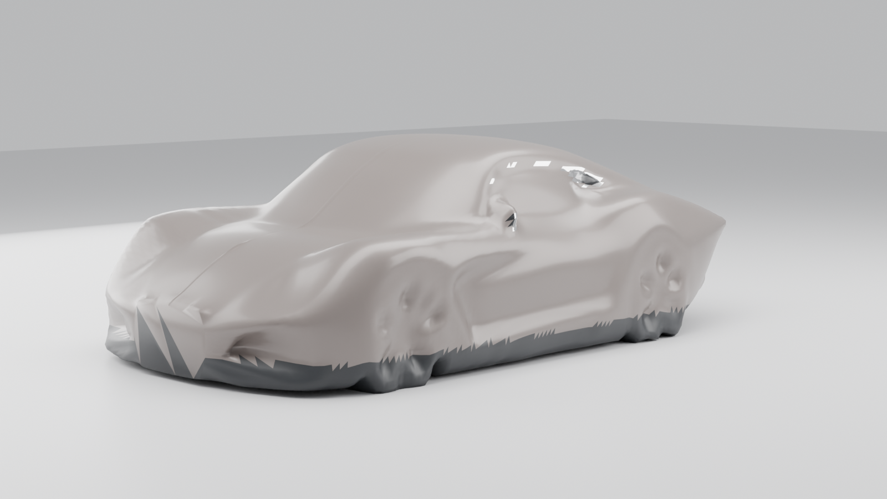
render/salida/ia-34frente.png
