rimopu10/carro/render/salida/ia-frontal.png

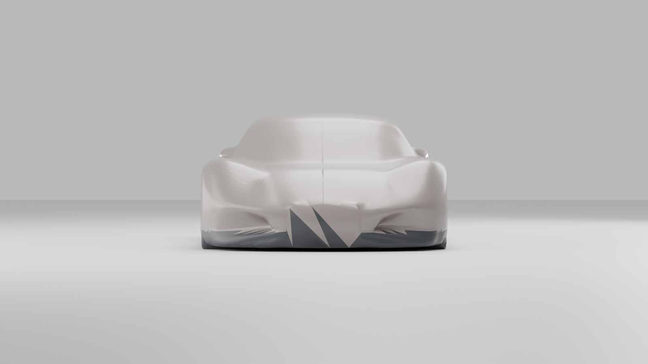
render/salida/ia-frontal.png
