rimopu10/carro/render/salida/ia-lateral.png

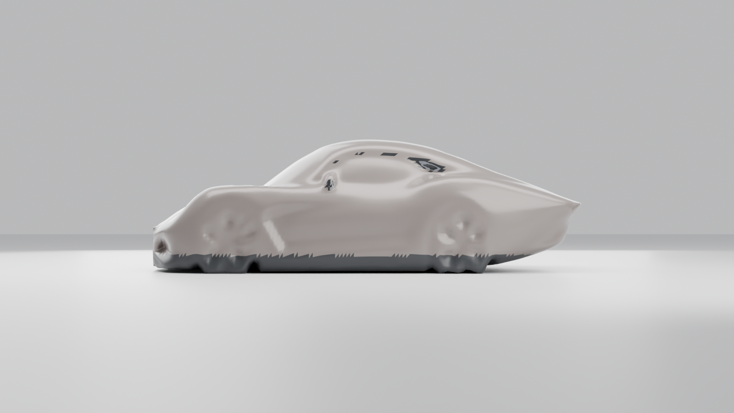
render/salida/ia-lateral.png
