rimopu10/carro/render/salida/luces-hoja.png

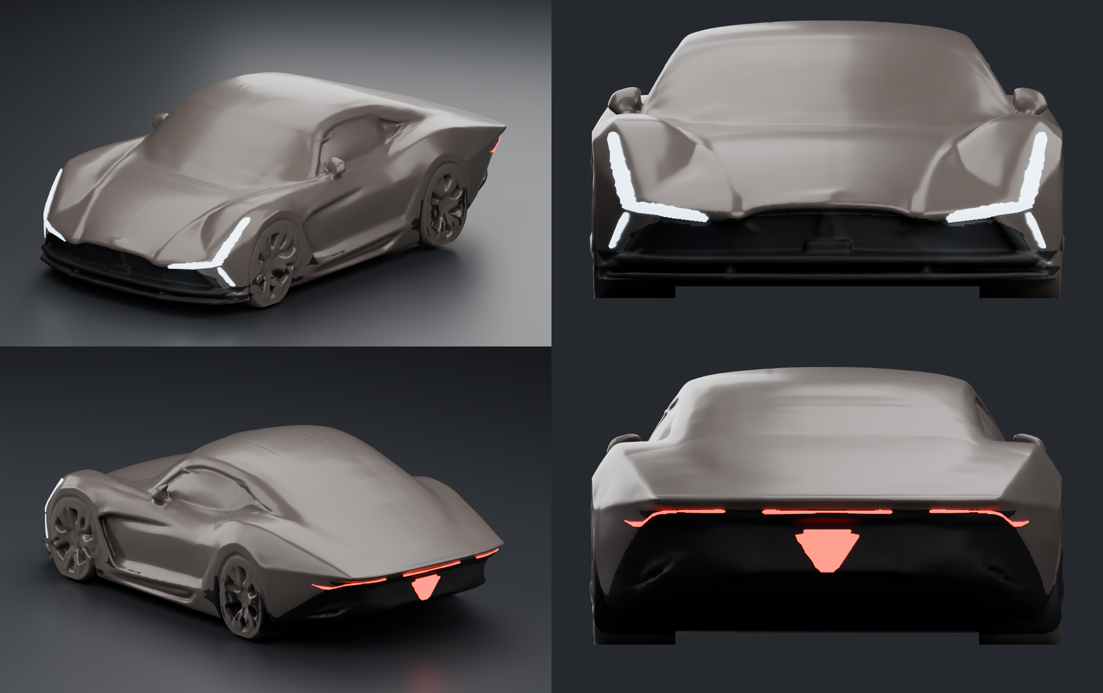
render/salida/luces-hoja.png
