rimopu10/carro/render/salida/tripo/cenital.png

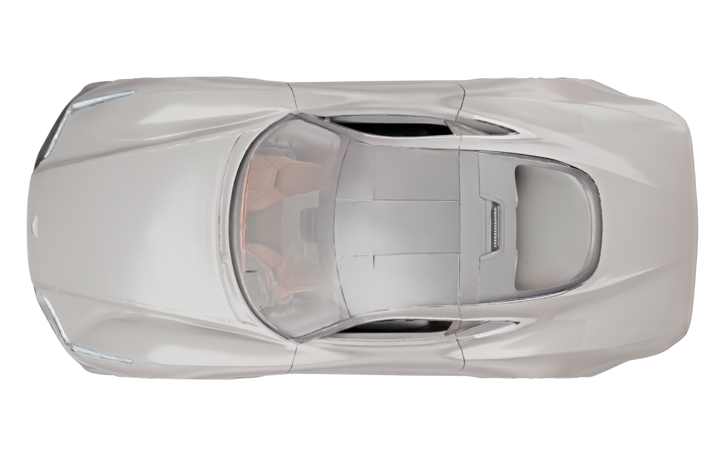
render/salida/tripo/cenital.png
