rimopu10/carro/render/salida/tripo/comparacion.png

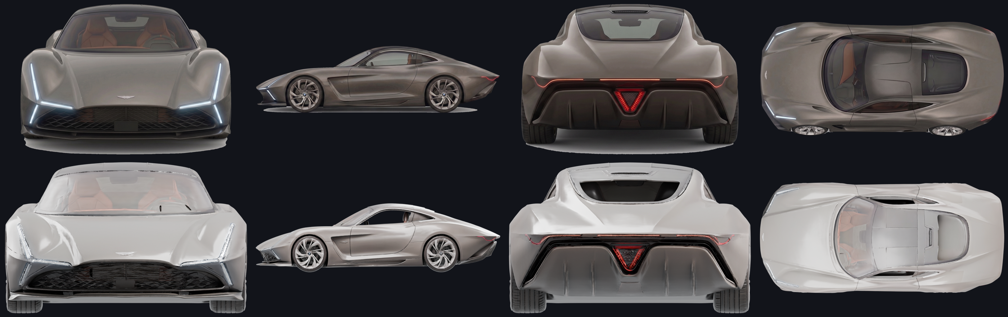
render/salida/tripo/comparacion.png
