rimopu10/carro/render/salida/tripo/frontal.png

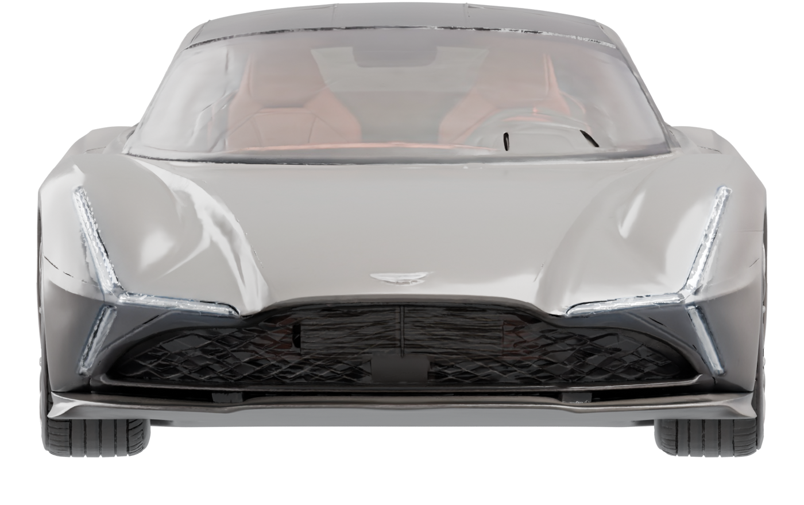
render/salida/tripo/frontal.png
