rimopu10/carro/render/salida/tripo/lateral.png

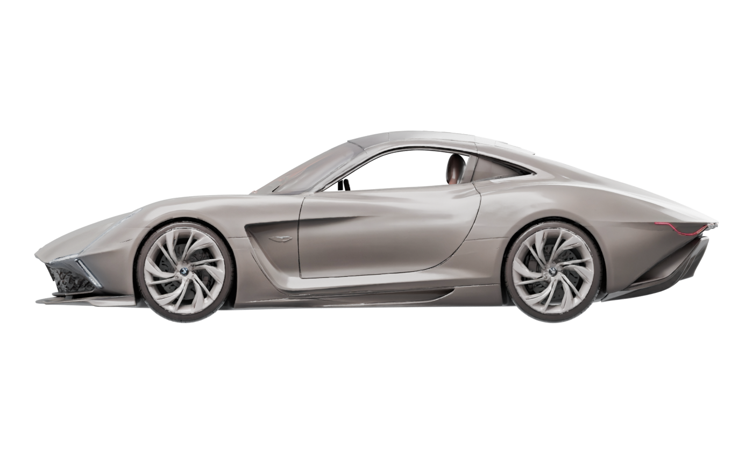
render/salida/tripo/lateral.png
