rimopu10/carro/render/salida/tripo/trasera.png

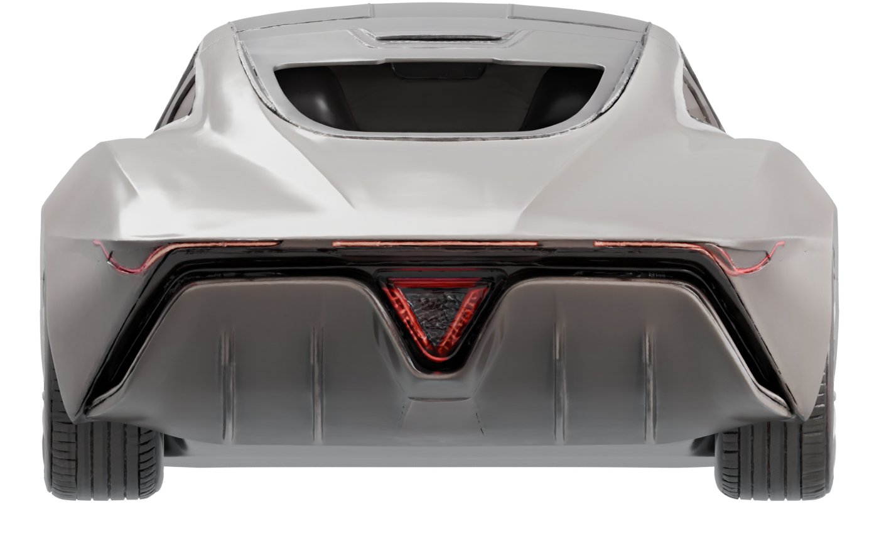
render/salida/tripo/trasera.png
