rimopu10/carro/render/salida/tripo/tres_cuartos.png

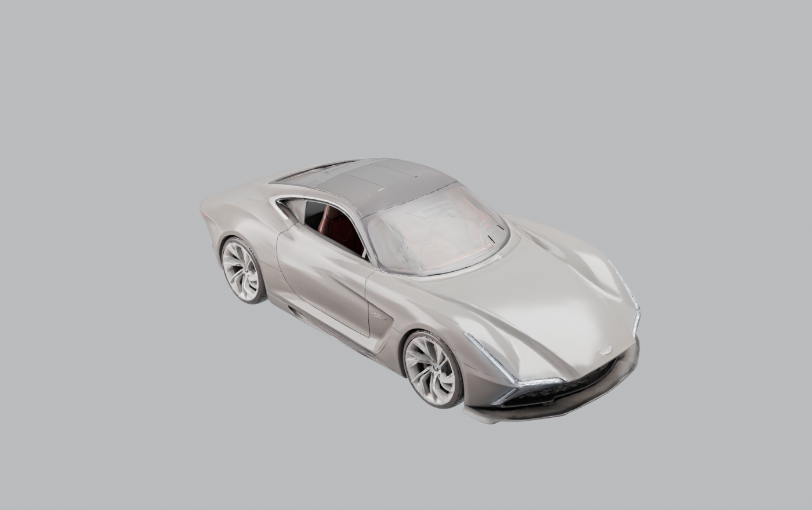
render/salida/tripo/tres_cuartos.png
