rimopu10/carro/render/salida/tripo/tres_cuartos_tras.png

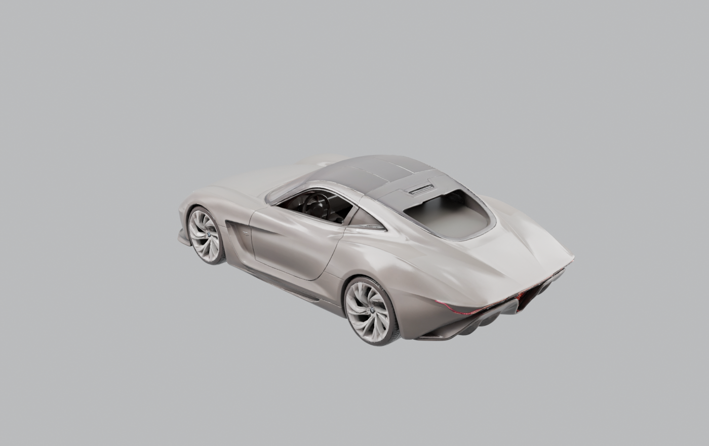
render/salida/tripo/tres_cuartos_tras.png
