rimopu10/carro/render/salida/v3/detalle_cola.png

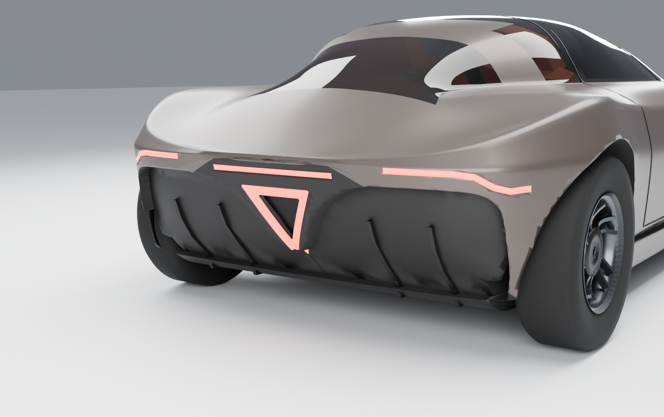
render/salida/v3/detalle_cola.png
