rimopu10/carro/render/salida/v3/detalle_frente.png

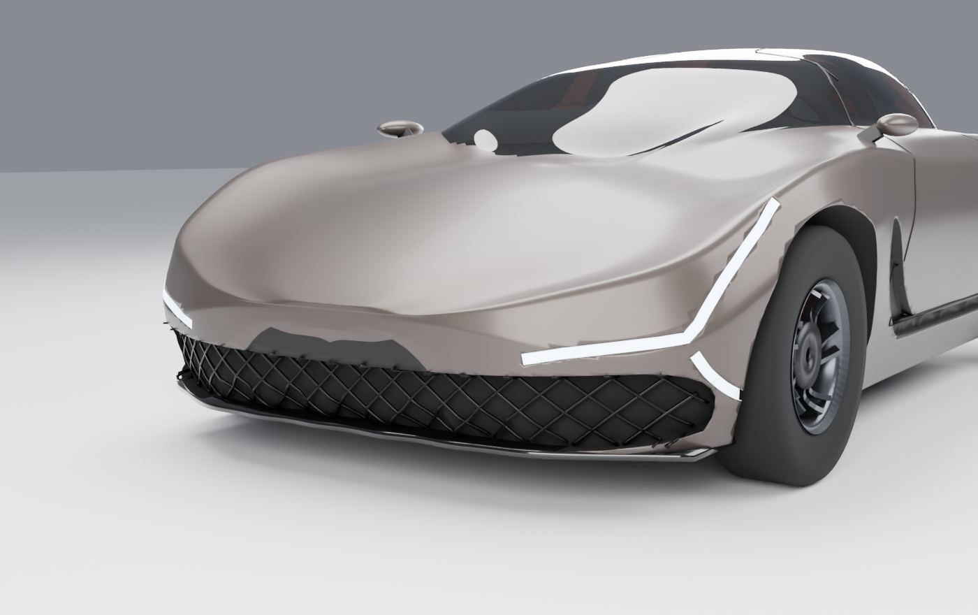
render/salida/v3/detalle_frente.png
