rimopu10/carro/render/salida/v3/siluetas.png

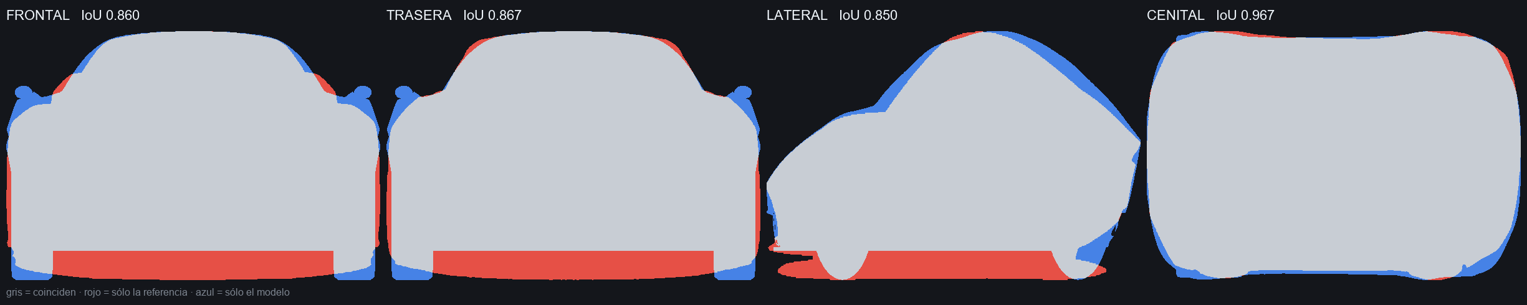
render/salida/v3/siluetas.png
