rimopu10/carro/cad/carro-v3-carroceria-mm.stl

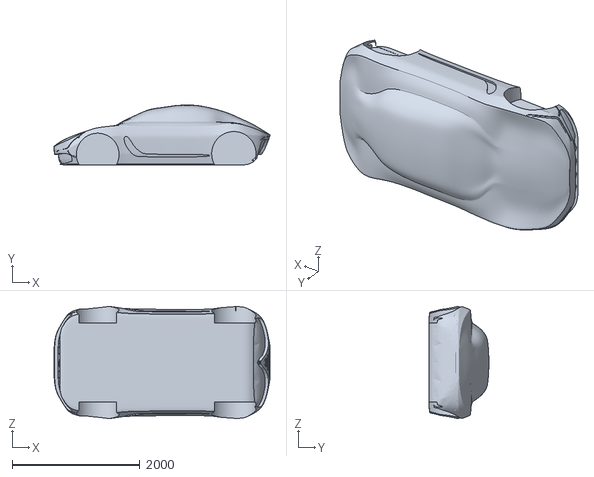
[picture p69: CAD file, 2026-10-10]
cad/carro-v3-carroceria-mm.stl
3380.0 x 936.2 x 1754.2
