rimopu10/carro/impresion/ender3v3se/gaviota-1a20-placa1-carroceria.stl

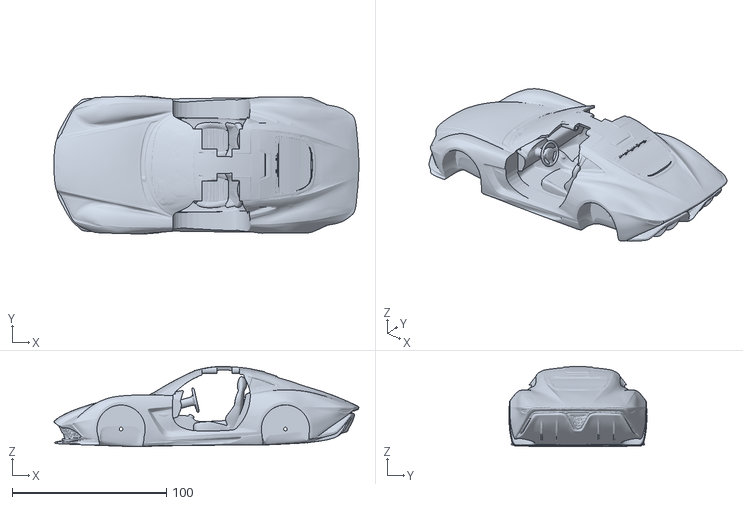
[picture p70: CAD file, 2026-10-10]
impresion/ender3v3se/gaviota-1a20-placa1-carroceria.stl
197.7 x 89.2 x 51.9
