rimopu10/carro/impresion/gaviota-1a20-puerta-der.stl

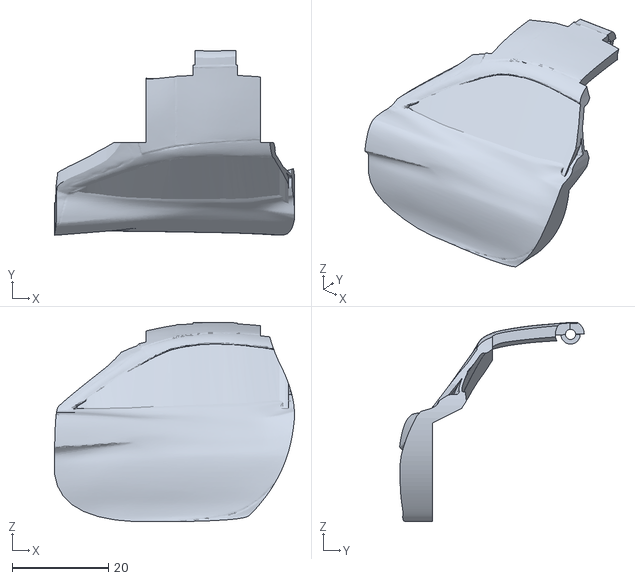
[picture p71: CAD file, 2026-10-10]
impresion/gaviota-1a20-puerta-der.stl
49.8 x 38.3 x 41.4
