rimopu10/carro/planos/placa-torque-refuerzo.dxf

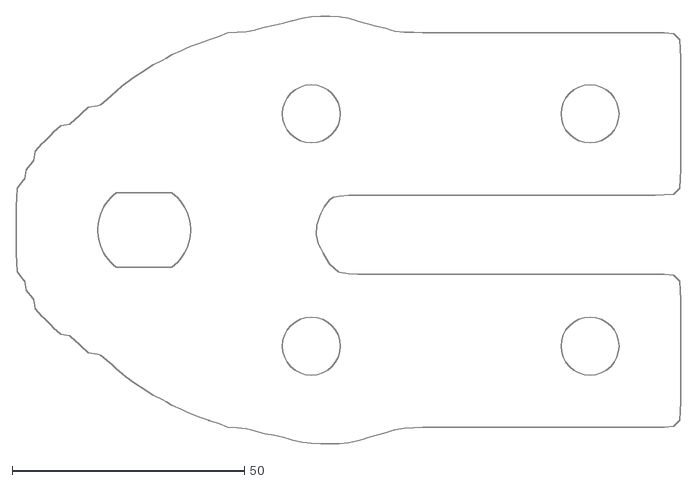
[picture p72: CAD file, 2026-08-05]
planos/placa-torque-refuerzo.dxf
143.0 x 92.0
