rimopu10/carro/cad/nodo-susp_tras.stl

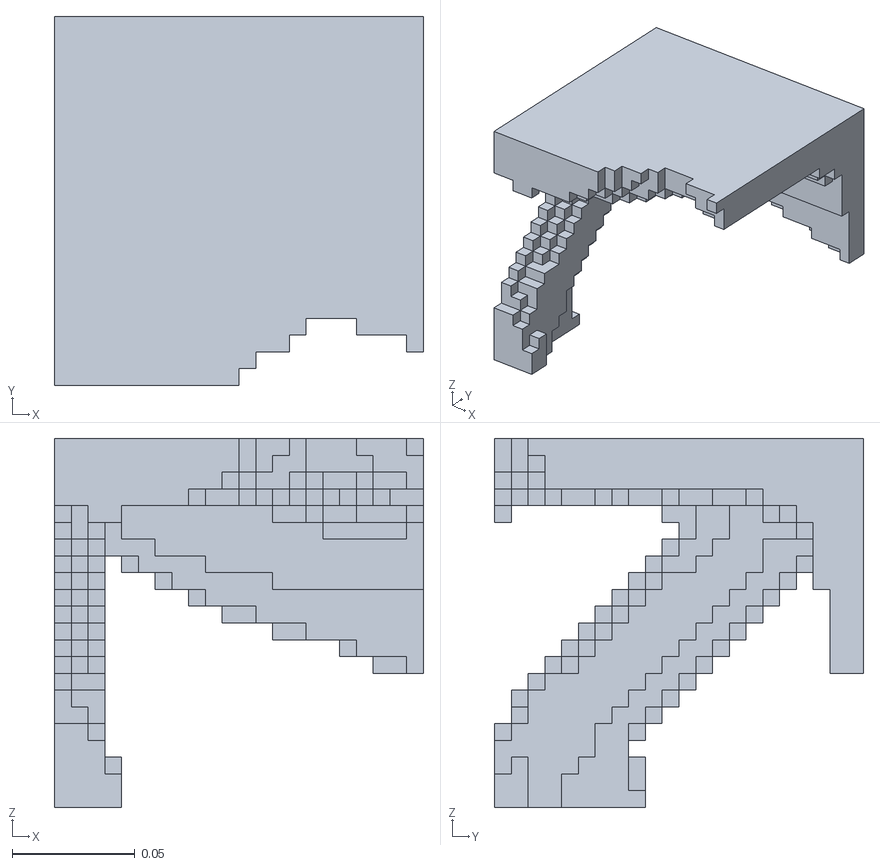
[picture p73: CAD file, 2026-07-06]
cad/nodo-susp_tras.stl
0.15 x 0.15 x 0.15
