rimopu10/carro/impresion/ender3v3se/gaviota-1a20-placa2-puertas-y-ruedas.stl

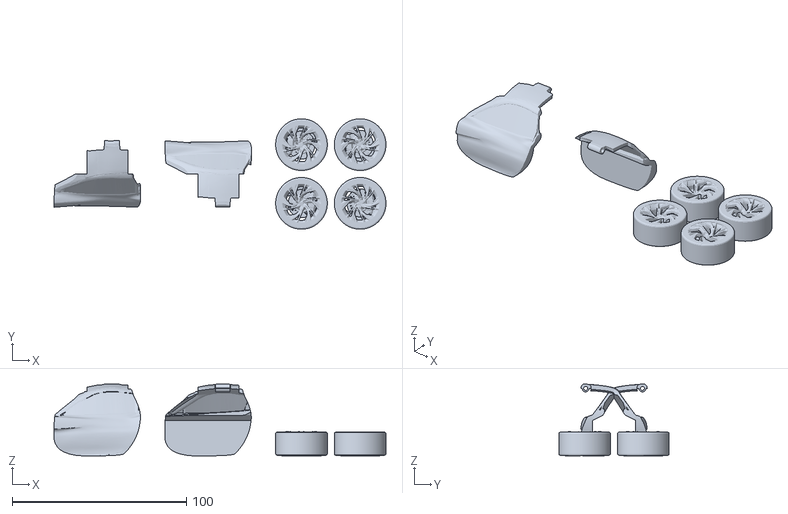
[picture p74: CAD file, 2026-10-10]
impresion/ender3v3se/gaviota-1a20-placa2-puertas-y-ruedas.stl
190.7 x 63.4 x 41.3
