rimopu10/carro/impresion/juguete-tripo-1a20-rodante-carroceria.stl

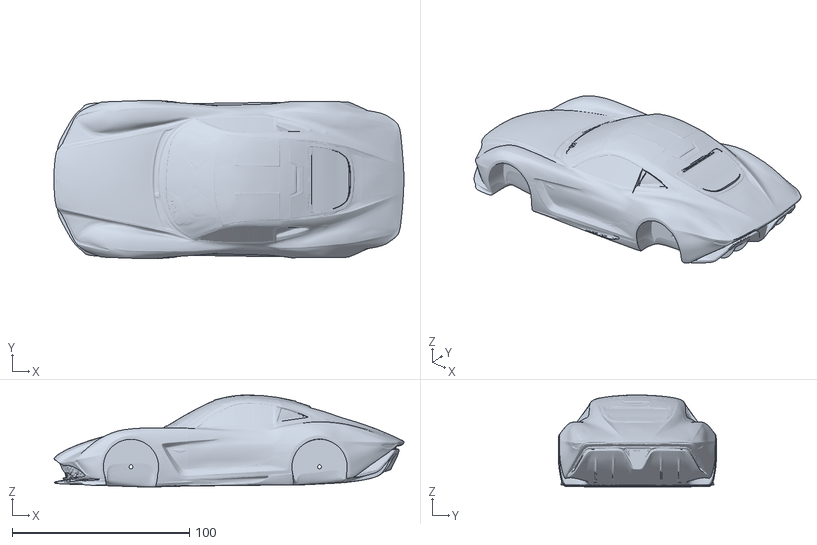
[picture p75: CAD file, 2026-10-10]
impresion/juguete-tripo-1a20-rodante-carroceria.stl
197.7 x 89.2 x 51.9
