rimopu10/carro/planos/placa-torque-doblador.dxf

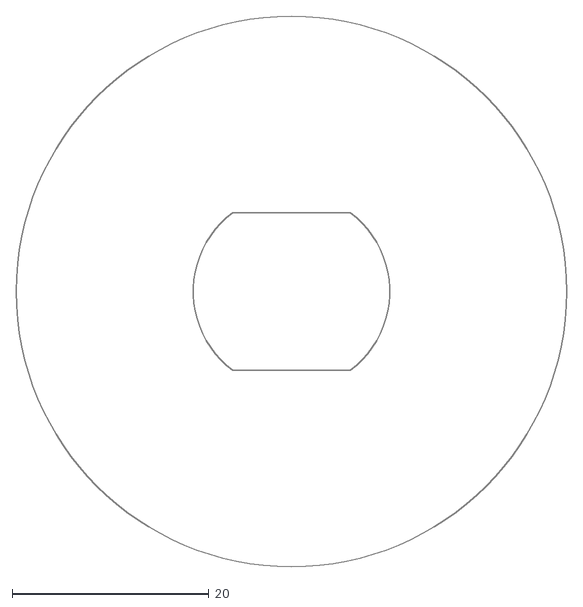
[picture p76: CAD file, 2026-08-05]
planos/placa-torque-doblador.dxf
56.0 x 56.0
