rimopu10/carro/cad/nodo-pilar_a.stl

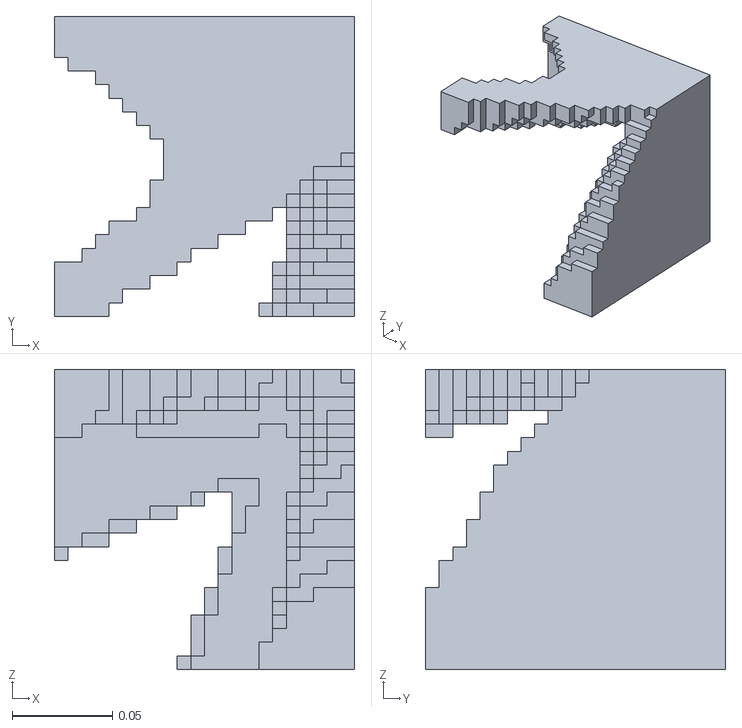
[picture p77: CAD file, 2026-07-06]
cad/nodo-pilar_a.stl
0.15 x 0.15 x 0.15
