rimopu10/carro/impresion/ender3v3se/prueba-tolerancias-ejes.stl

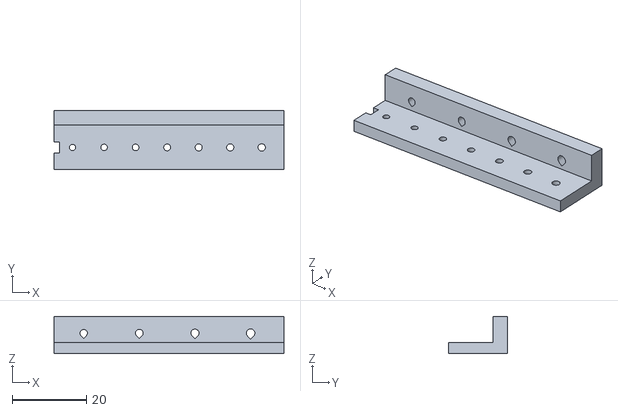
[picture p78: CAD file, 2026-10-10]
impresion/ender3v3se/prueba-tolerancias-ejes.stl
62.0 x 16.0 x 10.0
