rimopu10/carro/planos/placa-torque-motor.dxf

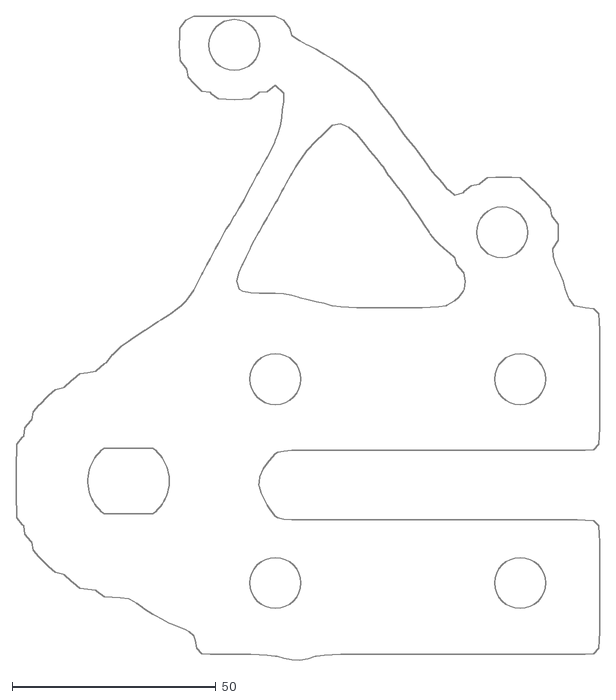
[picture p79: CAD file, 2026-08-05]
planos/placa-torque-motor.dxf
143.0 x 157.9
