rimopu10/carro/cad/nodo-arco_ppal.stl

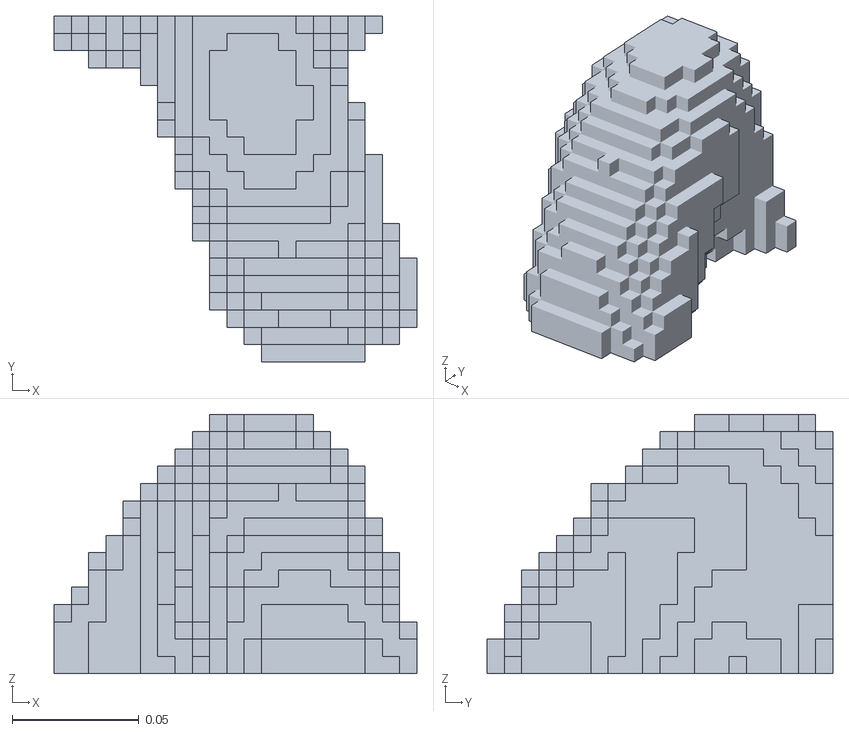
[picture p80: CAD file, 2026-07-06]
cad/nodo-arco_ppal.stl
0.143 x 0.136 x 0.102
