rimopu10/carro/planos/cartela-pivote-brazo.dxf

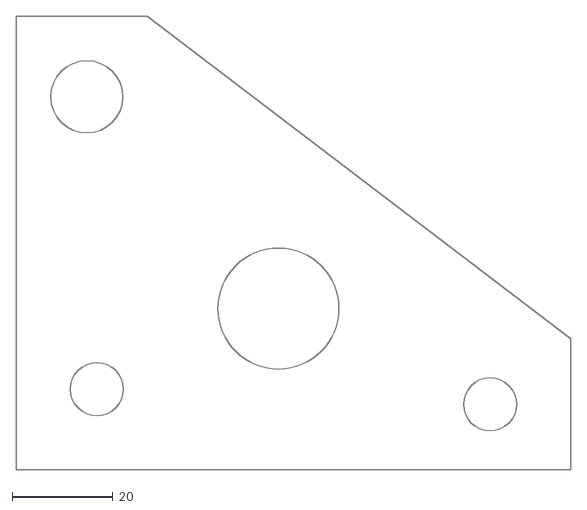
[picture p81: CAD file, 2026-07-06]
planos/cartela-pivote-brazo.dxf
110.0 x 90.0
