rimopu10/carro/cad/nodo-cuna_bat.stl

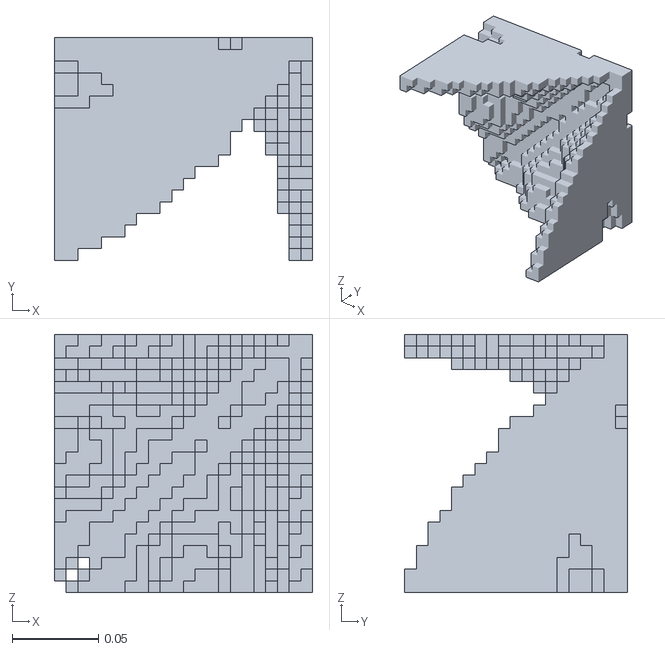
[picture p82: CAD file, 2026-07-06]
cad/nodo-cuna_bat.stl
0.15 x 0.13 x 0.15
