rimopu10/carro/planos/cartela-torre-coilover.dxf

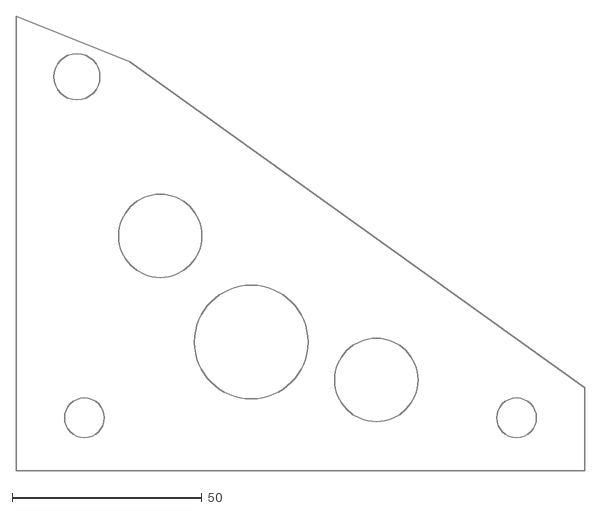
[picture p83: CAD file, 2026-07-06]
planos/cartela-torre-coilover.dxf
150.0 x 120.0
