rimopu10/carro/cad/nodo-suspension.stl

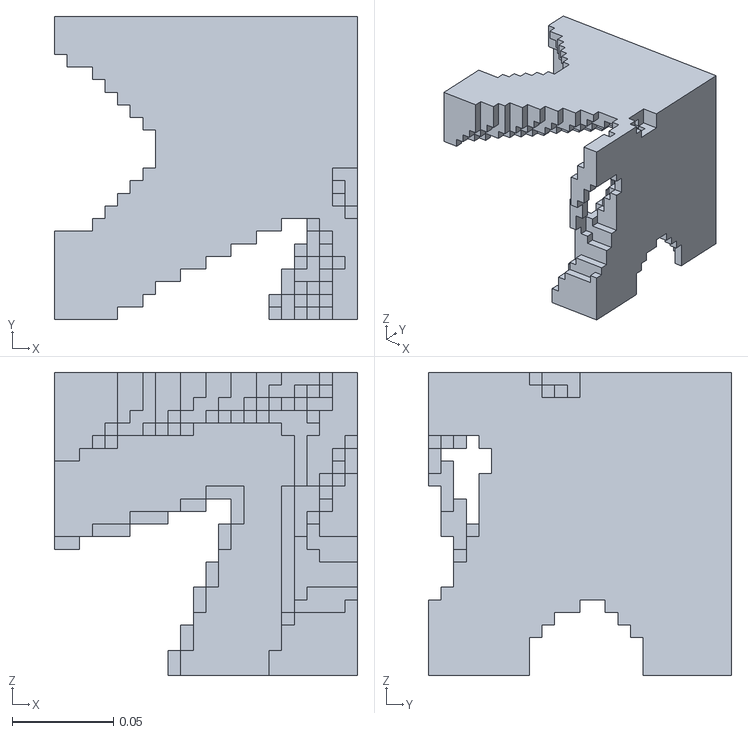
[picture p84: CAD file, 2026-07-06]
cad/nodo-suspension.stl
0.15 x 0.15 x 0.15
