rimopu10/carro/planos/placa-cuna-bateria.dxf

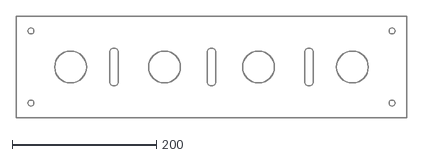
[picture p85: CAD file, 2026-07-06]
planos/placa-cuna-bateria.dxf
540.0 x 140.0
