rimopu10/carro/impresion/gaviota-1a20-ruedas-x4.stl

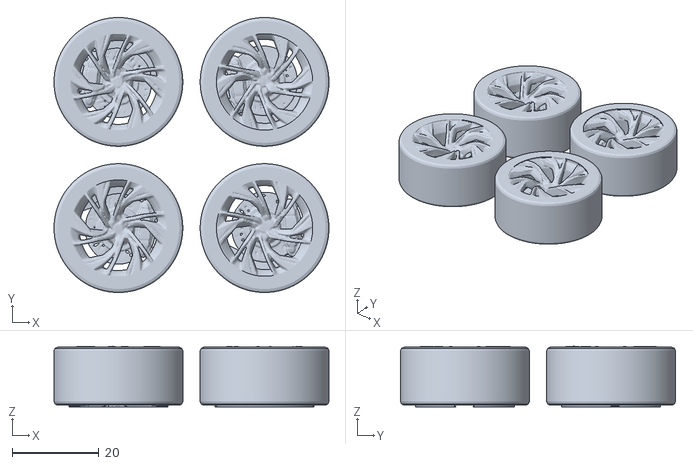
[picture p86: CAD file, 2026-10-10]
impresion/gaviota-1a20-ruedas-x4.stl
63.4 x 63.4 x 14.0
