rimopu10/carro/impresion/maqueta-1a12-carroceria-cola.stl

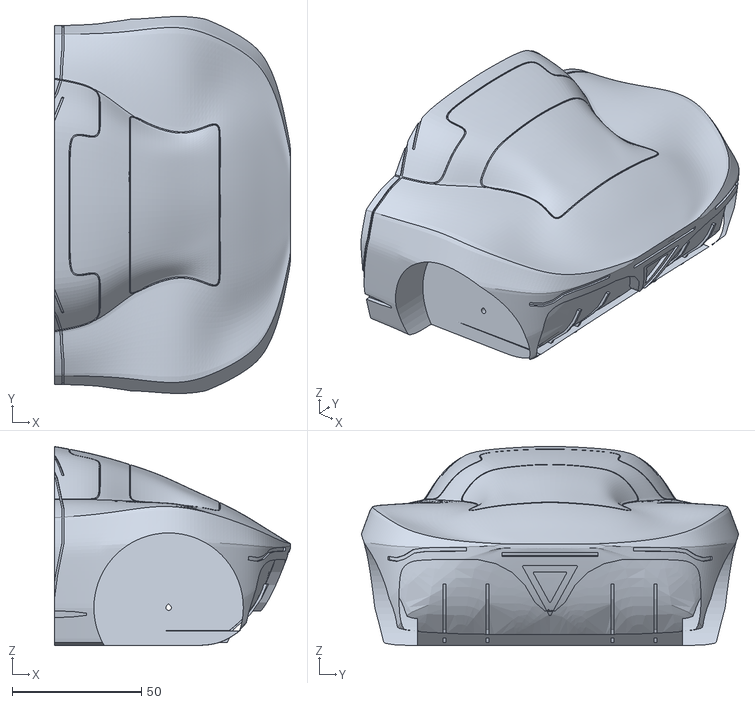
[picture p87: CAD file, 2026-10-10]
impresion/maqueta-1a12-carroceria-cola.stl
91.3 x 145.7 x 76.9
