rimopu10/carro/impresion/maqueta-1a12-arandelas-x4.stl

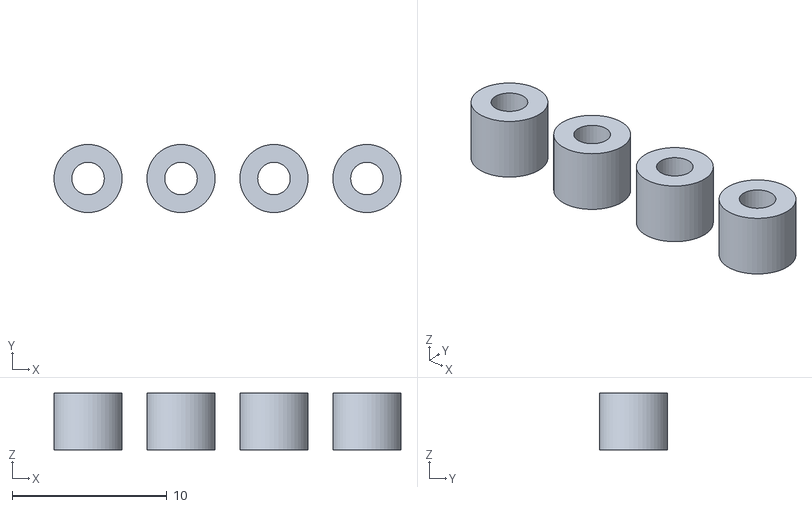
[picture p88: CAD file, 2026-10-10]
impresion/maqueta-1a12-arandelas-x4.stl
22.4 x 4.40 x 3.67
