rimopu10/carro/impresion/maqueta-1a16-carroceria.stl

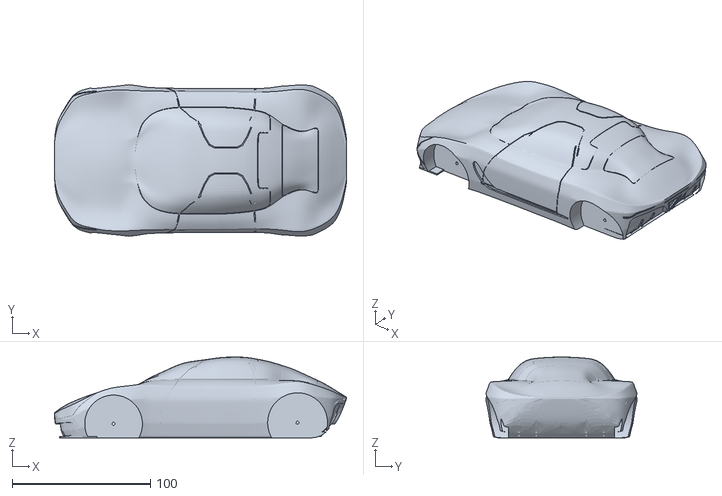
[picture p89: CAD file, 2026-10-10]
impresion/maqueta-1a16-carroceria.stl
211.3 x 109.6 x 58.5
