rimopu10/carro/impresion/maqueta-1a16-ruedas-delantera-x2.stl

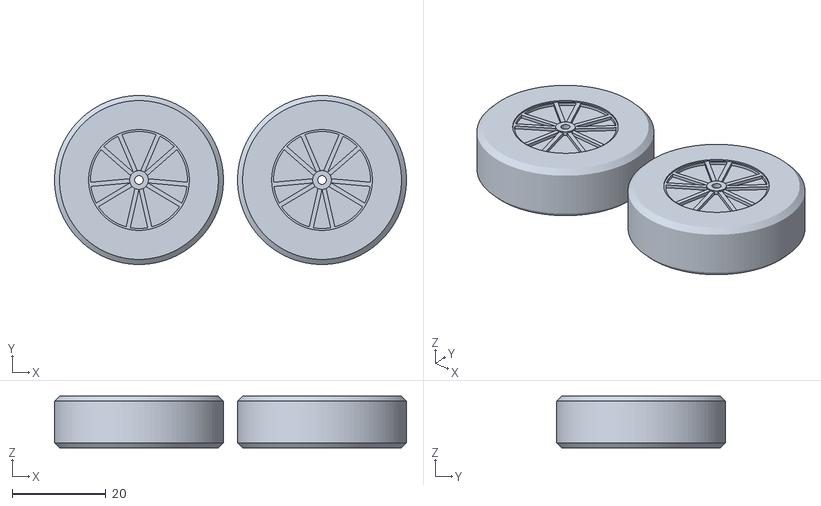
[picture p90: CAD file, 2026-10-10]
impresion/maqueta-1a16-ruedas-delantera-x2.stl
74.9 x 36.0 x 11.1
