rimopu10/carro/impresion/maqueta-1a12-ruedas-delantera-x2.stl

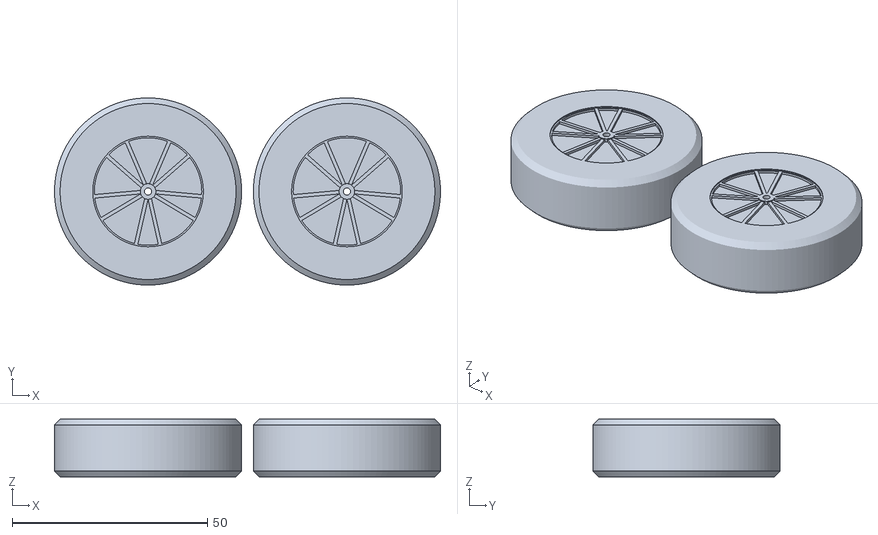
[picture p91: CAD file, 2026-10-10]
impresion/maqueta-1a12-ruedas-delantera-x2.stl
98.9 x 47.9 x 14.8
