rimopu10/carro/impresion/maqueta-1a16-ruedas-trasera-x2.stl

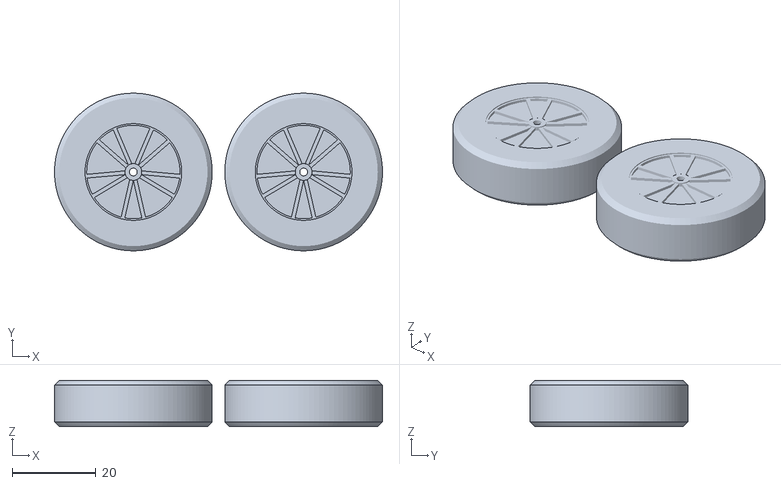
[picture p92: CAD file, 2026-10-10]
impresion/maqueta-1a16-ruedas-trasera-x2.stl
78.1 x 37.6 x 11.1
