rimopu10/carro/impresion/maqueta-1a12-carroceria-frente.stl

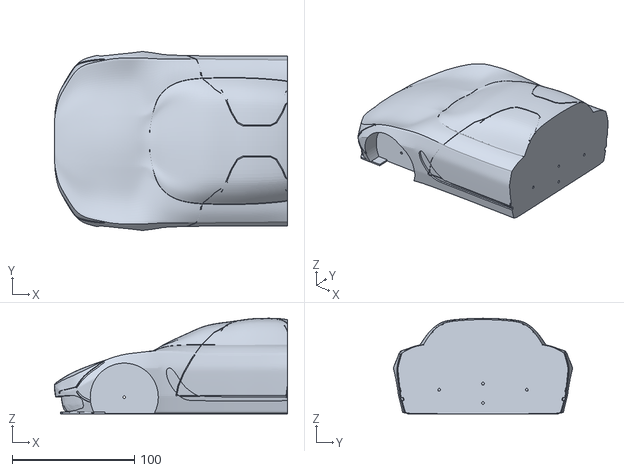
[picture p93: CAD file, 2026-10-10]
impresion/maqueta-1a12-carroceria-frente.stl
190.3 x 146.2 x 78.0
