rimopu10/carro/impresion/maqueta-1a16-arandelas-x4.stl

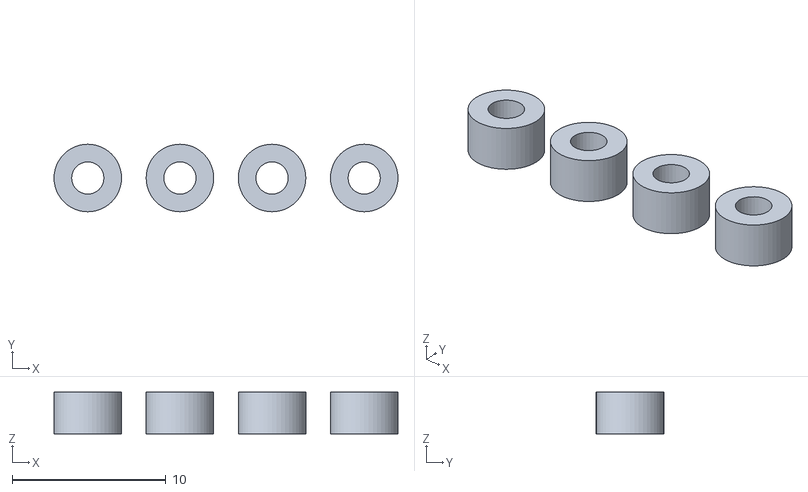
[picture p94: CAD file, 2026-10-10]
impresion/maqueta-1a16-arandelas-x4.stl
22.4 x 4.40 x 2.71
