rimopu10/carro/impresion/maqueta-1a12-ruedas-trasera-x2.stl

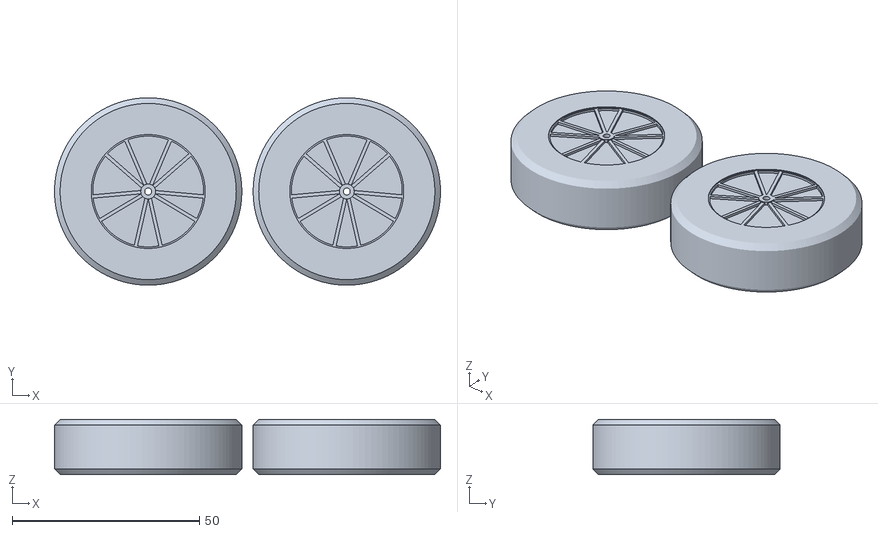
[picture p95: CAD file, 2026-10-10]
impresion/maqueta-1a12-ruedas-trasera-x2.stl
103.2 x 50.1 x 14.8
