rimopu10/carro/(list of files, cad)

Other CAD files:
impresion/gaviota-1a20-puerta-izq.stl
impresion/juguete-tripo-1a64.stl
impresion/juguete-tripo-1a20.stl
impresion/gaviota-1a20-carroceria.stl
impresion/juguete-tripo-1a20-rodante-ruedas-x4.stl
