rimopu10/carro/calculos/resultados-analisis.md

# Resultados del análisis estructural del chasis

Método: rigidez directa, vigas 3D 12-GDL, uniones rígidas, estático lineal.
Acero fy=250 MPa · E=200 GPa · PTR 38×38×1.9 y arcos RED 44.5×2.1.

**Miembros:** 104 tubos · **masa del chasis:** 99.0 kg · **longitud total de tubo:** 37.8 m

## Rigidez torsional

**9,748 N·m/°** con par de 1500 N·m (objetivo para deportivo ligero artesanal: >4,000 N·m/°; un kit car típico ronda 2,000-6,000).

## LC1 Bache 3g

Factor de seguridad mínimo: **2.0** (>2.0 requerido, >3.0 deseable)

Los 10 tubos más esforzados:

| Tubo | Función | Sección | σ máx (MPa) | FS fluencia | FS pandeo |
|---|---|---|---|---|---|
| dash_loR-dash_hiR | safe | PTR 38x38x1.9 | 122.5 | 2.0 | — |
| dash_loL-dash_hiL | safe | PTR 38x38x1.9 | 122.5 | 2.0 | — |
| smFL-cfF | asiento | PTR 38x38x3.0 | 104.9 | 2.4 | 3087.0 |
| smFR-cfF | asiento | PTR 38x38x3.0 | 104.9 | 2.4 | 3087.0 |
| mh_loR-mh_beltR | safe | RED 57.2x4.0 | 97.3 | 2.6 | — |
| mh_loL-mh_beltL | safe | RED 57.2x4.0 | 97.3 | 2.6 | — |
| dash_loR-cf1 | gen | PTR 25x25x1.9 | 91.8 | 2.7 | — |
| dash_loL-cf1 | gen | PTR 25x25x1.9 | 91.8 | 2.7 | — |
| mh_loL-smRL | tors | PTR 44x44x1.9 | 88.6 | 2.8 | — |
| mh_loR-smRR | tors | PTR 44x44x1.9 | 88.6 | 2.8 | — |

## LC5 Volcadura (2.0W vert + 0.75W lat)

Factor de seguridad mínimo: **1.8** (>2.0 requerido, >3.0 deseable)

Los 10 tubos más esforzados:

| Tubo | Función | Sección | σ máx (MPa) | FS fluencia | FS pandeo |
|---|---|---|---|---|---|
| seatL-mh_loL | gen | PTR 44x44x1.9 | 136.3 | 1.8 | — |
| mh_loL-bat_fL | gen | PTR 38x38x3.0 | 134.9 | 1.9 | — |
| dash_loL-dash_hiL | safe | PTR 38x38x1.9 | 118.4 | 2.1 | — |
| mh_hiL-sp_rL | safe | RED 57.2x3.2 | 113.9 | 2.2 | — |
| mh_beltR-mh_hiR | safe | RED 57.2x3.2 | 110.2 | 2.3 | 942.0 |
| fx_loL-dash_loL | gen | PTR 38x38x1.9 | 102.8 | 2.4 | 1749.7 |
| dash_hiL-hdrL | safe | RED 57.2x3.2 | 102.6 | 2.4 | 288.2 |
| mh_hiL-coilL | safe | RED 50.8x2.1 | 101.6 | 2.5 | 124.7 |
| sp_fL-h1L | safe | RED 57.2x3.2 | 101.0 | 2.5 | 11820.7 |
| hdrL-saL | safe | RED 57.2x3.2 | 100.2 | 2.5 | 25811.2 |

## LC5b Volcadura FIA (7.5W + 5.5W)

Factor de seguridad mínimo: **0.3** (>2.0 requerido, >3.0 deseable)

Los 10 tubos más esforzados:

| Tubo | Función | Sección | σ máx (MPa) | FS fluencia | FS pandeo |
|---|---|---|---|---|---|
| mh_loL-bat_fL | gen | PTR 38x38x3.0 | 767.4 | 0.3 | — |
| seatL-mh_loL | gen | PTR 44x44x1.9 | 716.6 | 0.3 | — |
| mh_hiL-sp_rL | safe | RED 57.2x3.2 | 686.0 | 0.4 | — |
| r_hiL-r_hiR | gen | PTR 38x38x1.9 | 657.0 | 0.4 | — |
| mh_beltR-baR | safe | RED 57.2x3.2 | 637.2 | 0.4 | 7791.8 |
| coilL-r_hiL | safe | RED 50.8x2.1 | 628.2 | 0.4 | — |
| dash_loL-dash_hiL | safe | PTR 38x38x1.9 | 617.3 | 0.4 | — |
| mh_hiR-sp_rR | safe | RED 57.2x3.2 | 613.2 | 0.4 | 914.8 |
| bat_fL-taL | gen | PTR 38x38x3.0 | 605.9 | 0.4 | — |
| taL-bat_rL | gen | PTR 38x38x3.0 | 592.3 | 0.4 | 284.2 |

## LC5c Volcadura sobre la cabecera (1.0W vert + 0.5W lat)

Factor de seguridad mínimo: **1.8** (>2.0 requerido, >3.0 deseable)

Los 10 tubos más esforzados:

| Tubo | Función | Sección | σ máx (MPa) | FS fluencia | FS pandeo |
|---|---|---|---|---|---|
| dash_hiL-hdrL | safe | RED 57.2x3.2 | 136.2 | 1.8 | 403.3 |
| sp_fR-h1R | safe | RED 57.2x3.2 | 110.8 | 2.3 | 49397.0 |
| dash_hiR-hdrR | safe | RED 57.2x3.2 | 108.5 | 2.3 | 633.0 |
| fx_hiL-dash_hiL | safe | PTR 38x38x1.9 | 104.3 | 2.4 | 1169.2 |
| hdrL-saL | safe | RED 57.2x3.2 | 101.6 | 2.5 | — |
| saR-sp_fR | safe | RED 57.2x3.2 | 92.4 | 2.7 | 13664.3 |
| saL-sp_fL | safe | RED 57.2x3.2 | 90.6 | 2.8 | — |
| h2L-sp_rL | safe | RED 57.2x3.2 | 90.1 | 2.8 | 8371.8 |
| sp_fL-h1L | safe | RED 57.2x3.2 | 88.3 | 2.8 | 24194.5 |
| mh_hiL-sp_rL | safe | RED 57.2x3.2 | 84.9 | 2.9 | 3035.5 |

## LC7 Puertas abiertas a 65° (3g + viento 400 N + amortiguador)

Factor de seguridad mínimo: **6.8** (>2.0 requerido, >3.0 deseable)

Los 10 tubos más esforzados:

| Tubo | Función | Sección | σ máx (MPa) | FS fluencia | FS pandeo |
|---|---|---|---|---|---|
| sp_fL-sp_fR | safe | RED 50.8x2.1 | 36.6 | 6.8 | — |
| dash_hiR-hdrR | safe | RED 57.2x3.2 | 29.4 | 8.5 | 2849.1 |
| dash_hiL-hdrL | safe | RED 57.2x3.2 | 29.4 | 8.5 | 2849.1 |
| saL-sp_fL | safe | RED 57.2x3.2 | 27.8 | 9.0 | 36811.8 |
| saR-sp_fR | safe | RED 57.2x3.2 | 27.8 | 9.0 | 36811.8 |
| hdrL-saL | safe | RED 57.2x3.2 | 27.4 | 9.1 | 918571.9 |
| hdrR-saR | safe | RED 57.2x3.2 | 27.4 | 9.1 | 918571.9 |
| sp_fR-h1R | safe | RED 57.2x3.2 | 24.0 | 10.4 | — |
| sp_fL-h1L | safe | RED 57.2x3.2 | 24.0 | 10.4 | — |
| fx_hiL-dash_hiL | safe | PTR 38x38x1.9 | 22.5 | 11.1 | 9287.4 |

## LC8 Arnés 10 g (5.3 kN por asiento en la barra de cinturones)

Factor de seguridad mínimo: **2.0** (>2.0 requerido, >3.0 deseable)

Los 10 tubos más esforzados:

| Tubo | Función | Sección | σ máx (MPa) | FS fluencia | FS pandeo |
|---|---|---|---|---|---|
| mh_beltL-mh_hiL | safe | RED 57.2x3.2 | 123.5 | 2.0 | — |
| mh_beltR-mh_hiR | safe | RED 57.2x3.2 | 123.5 | 2.0 | — |
| mh_loR-mh_beltR | safe | RED 57.2x4.0 | 88.7 | 2.8 | — |
| mh_loL-mh_beltL | safe | RED 57.2x4.0 | 88.7 | 2.8 | — |
| mh_hiR-coilR | safe | RED 50.8x2.1 | 85.8 | 2.9 | — |
| mh_hiL-coilL | safe | RED 50.8x2.1 | 85.8 | 2.9 | — |
| seatR-mh_loR | gen | PTR 44x44x1.9 | 84.5 | 3.0 | 11427.6 |
| seatL-mh_loL | gen | PTR 44x44x1.9 | 84.5 | 3.0 | 11427.6 |
| mh_beltR-baR | safe | RED 57.2x3.2 | 80.1 | 3.1 | 49337.5 |
| mh_beltL-baL | safe | RED 57.2x3.2 | 80.1 | 3.1 | 49337.5 |

## LC3 Frenada 1g

Factor de seguridad mínimo: **3.0** (>2.0 requerido, >3.0 deseable)

Los 10 tubos más esforzados:

| Tubo | Función | Sección | σ máx (MPa) | FS fluencia | FS pandeo |
|---|---|---|---|---|---|
| fx_loL-dash_loL | gen | PTR 38x38x1.9 | 84.4 | 3.0 | 203.9 |
| smRL-cf2 | asiento | PTR 38x38x1.9 | 78.1 | 3.2 | — |
| fb_loR-fx_loR | susp | PTR 38x38x1.9 | 76.6 | 3.3 | 773.0 |
| fb_loL-fx_loL | susp | PTR 38x38x1.9 | 75.1 | 3.3 | 155.2 |
| seatFL-smFL | asiento | PTR 38x38x3.0 | 73.0 | 3.4 | 3553.4 |
| dash_loL-cf1 | gen | PTR 25x25x1.9 | 72.9 | 3.4 | — |
| anAMORTL-anAMORTR | gen | PTR 38x38x1.9 | 62.2 | 4.0 | — |
| fb_loL-fb_loR | gen | PTR 38x38x1.9 | 60.1 | 4.2 | — |
| dash_loL-dash_hiL | safe | PTR 38x38x1.9 | 59.0 | 4.2 | — |
| dash_loR-cf1 | gen | PTR 25x25x1.9 | 56.9 | 4.4 | — |

## LC4 Curva 1g

Factor de seguridad mínimo: **3.8** (>2.0 requerido, >3.0 deseable)

Los 10 tubos más esforzados:

| Tubo | Función | Sección | σ máx (MPa) | FS fluencia | FS pandeo |
|---|---|---|---|---|---|
| bat_fL-taL | gen | PTR 38x38x3.0 | 66.4 | 3.8 | — |
| bat_fL-cfB | batt | PTR 38x38x1.9 | 64.5 | 3.9 | 186.9 |
| fb_loL-fx_loL | susp | PTR 38x38x1.9 | 59.5 | 4.2 | — |
| fb_loR-fx_loR | susp | PTR 38x38x1.9 | 58.7 | 4.3 | 1017.1 |
| smRR-cf2 | asiento | PTR 38x38x1.9 | 56.4 | 4.4 | — |
| seatFR-seatR | gen | PTR 44x44x1.9 | 55.1 | 4.5 | 7742.1 |
| cf2-cfB | batt | PTR 38x38x1.9 | 54.8 | 4.6 | 4490.6 |
| taL-bat_rL | gen | PTR 38x38x3.0 | 53.5 | 4.7 | — |
| dash_loL-dash_hiL | safe | PTR 38x38x1.9 | 49.3 | 5.1 | — |
| smRL-cf2 | asiento | PTR 38x38x1.9 | 48.8 | 5.1 | — |

## Supuestos y límites

- Masas: batería 90 kg, 2 ocupantes 180 kg, controladores 15 kg, carrocería 40 kg en anclajes.
- Motores de cubo = masa no suspendida: no cargan el chasis en estos casos.
- No incluye: fatiga de soldadura, abolladura local, choque. Validar con FEM 3D antes de soldar.
