rimopu10/carro/ref/casco-verificacion.png

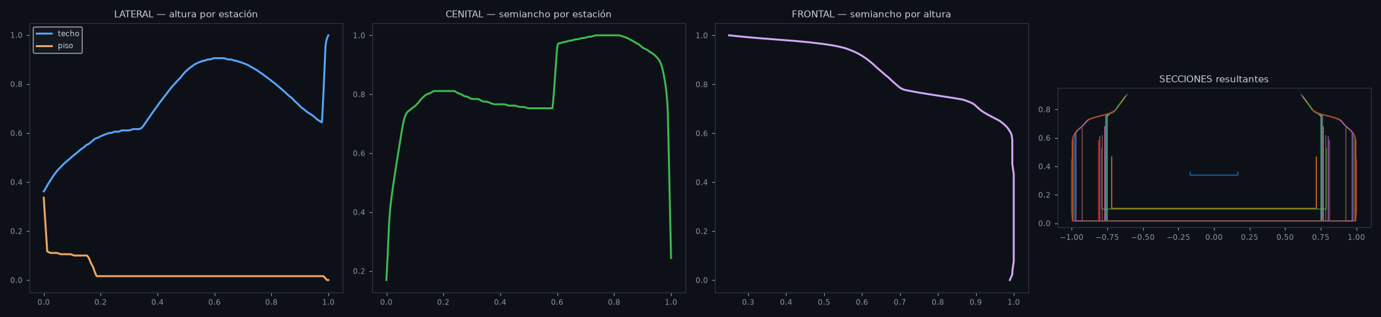
ref/casco-verificacion.png
