rimopu10/carro/ref/curvas-verificacion.png

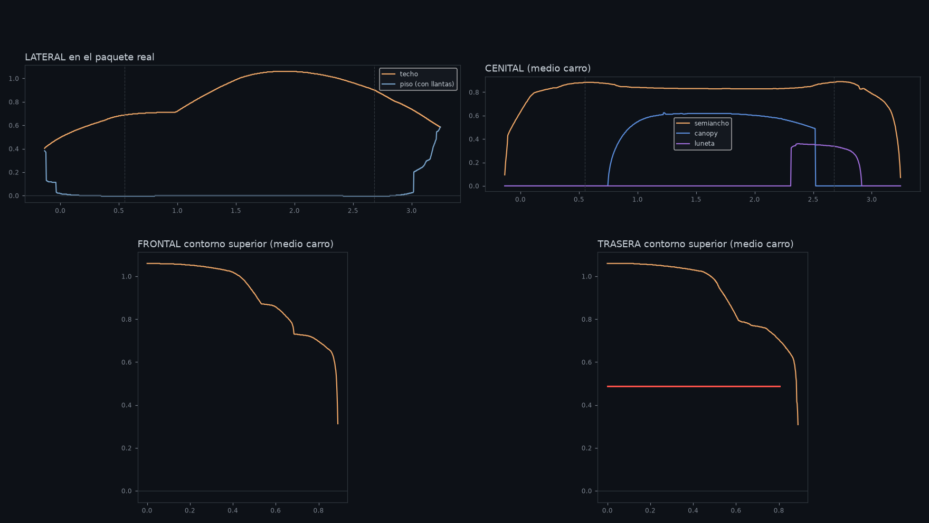
ref/curvas-verificacion.png
