rimopu10/carro/ref/silueta-verificacion.png

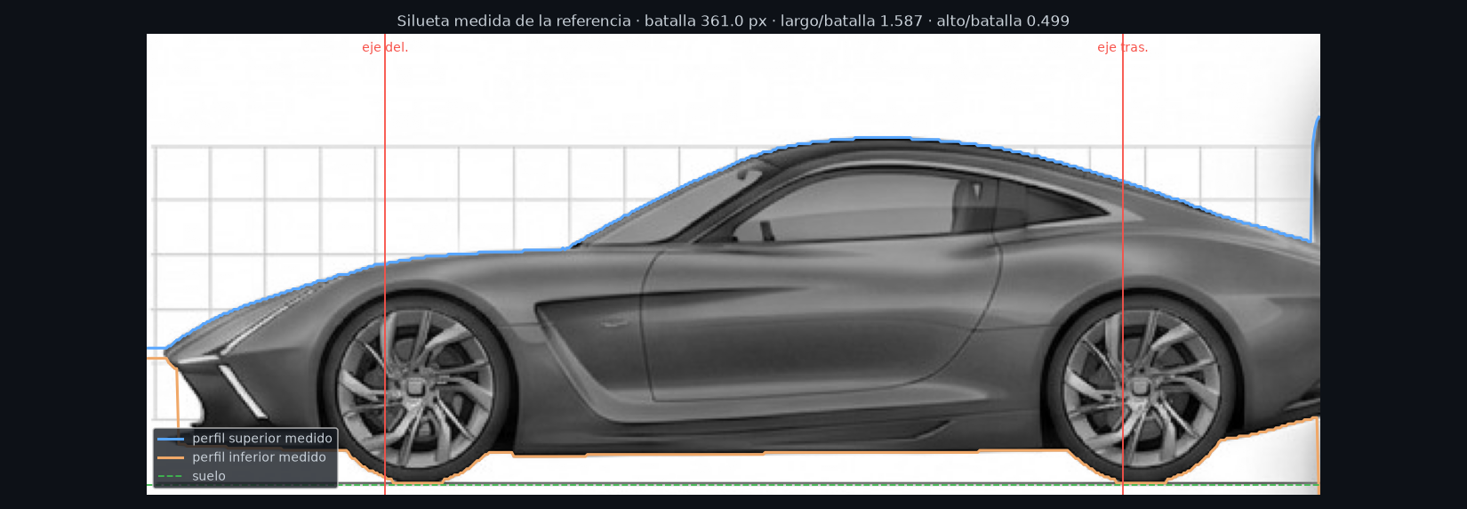
ref/silueta-verificacion.png
