rimopu10/carro/calculos/direccion.py

# -*- coding: utf-8 -*-
"""
DIRECCIÓN — geometría de Ackermann, relación, esfuerzo y círculo de giro.

La suspensión delantera ya fijó los puntos duros por barrido numérico (camber,
caster, bump steer 0.04°/25mm). Lo que faltaba es la DIRECCIÓN propiamente dicha:
cuánto gira cada rueda respecto de la otra (Ackermann), cuántas vueltas de volante,
qué tan pesado queda sin servo y en cuánto espacio da la vuelta.

Método: al girar el volante a una altura de suspensión dada, las rótulas LBJ y UBJ
NO se mueven — la mangueta simplemente rota alrededor del eje de kingpin. Eso
convierte el problema en una sola incógnita (el ángulo de rotación ψ) sujeta a que
el tie rod conserve su largo. Se resuelve exacto para las dos ruedas y de ahí salen
los ángulos reales de cada una, sin fórmulas aproximadas.

Toda la geometría se importa de `suspension_delantera.py` para que no haya dos
verdades: si allá se mueve un punto, aquí cambia solo.

Salidas:
  calculos/resultados-direccion.md
  calculos/direccion.png
"""
import numpy as np
from scipy.optimize import fsolve
import os, sys

HERE = os.path.dirname(os.path.abspath(__file__))
sys.path.insert(0, HERE)
import suspension_delantera as sd          # re-genera su propio informe (idempotente)
import analisis_chasis as ac               # para revisar holgura contra los tubos

import matplotlib
matplotlib.use("Agg")
import matplotlib.pyplot as plt

# ============================================================================
# 1. DATOS
# ============================================================================
BATALLA = 2.13          # m, eje delantero x=550 → eje trasero x=2680
TROCHA_DEL = 2 * sd.W0[2]
MASA = 690.0
DIST_DEL = sd.DIST_DEL
R_RUEDA = sd.R_RUEDA
G = 9.81

# --- objetivos ---
ACK_OBJ = 85.0          # % de Ackermann buscado (carro de calle/terreno, no pista)
# El bump steer MANDA sobre el Ackermann: uno hace que el carro se dirija solo al
# pasar un tope (seguridad), el otro solo desgasta llanta en maniobra lenta.
BS_PREF = 0.060         # °/25 mm, tope preferido — se busca el mejor Ackermann bajo él
BS_MAX = 0.100          # °/25 mm, tope duro (el heredado es 0.043)
DELTA_REF = 20.0        # ° de la rueda exterior donde se mide el Ackermann

# --- cremallera y volante ---
P_RACK = 0.045          # m de carrera de cremallera por vuelta de volante (manual típica)
D_VOLANTE = 0.330       # m
S_RACK_MAX = 0.075      # m de carrera de cremallera a cada lado (tope físico típico)
P_LLANTA = 2.2e5        # Pa, presión de inflado
MU_PISO = 0.80          # coeficiente llanta-piso para el par de pivotamiento parado

# --- puntos duros heredados (NO se tocan: fijan camber/caster/bump steer) ---
LBJ, UBJ = sd.LBJ0, sd.UBJ0
TR0 = sd.TR0
# Posición VIGENTE de la cremallera: vive en suspension_delantera.py, que es la única
# fuente de la geometría delantera. Este script la verifica, no la inventa.
RACK0 = sd.RACK
# Posición PREVIA, la que tenía el diseño antes de mirar el Ackermann. Se conserva
# como referencia histórica para poder mostrar el antes y el después.
RACK_PREV = np.array([0.410, 0.207, 0.510])
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
