rimopu10/carro/(commit log)

2026-07-06 Diseno maestro + paquete de ingenieria del carro electrico 2 plazas
    - Documento maestro de diseno (specs, decisiones, seguridad, fases, presupuesto)
    - Analisis estructural real del chasis: FEM de vigas 3D, 4 casos de carga
    (rigidez torsional 10,868 Nm/deg, FS min 2.22 en bache 3g)
    - Lista de corte de 73 tubos (41.9 m de PTR)
    - DXF para corte laser: cartelas coilover, pivote de brazo, placas cuna bateria
    [cartela-pivote-brazo.dxf, cartela-torre-coilover.dxf, lista-corte-tubos.csv, placa-cuna-bateria.dxf]
2026-07-06 Motor de diseno generativo real: optimizacion topologica 3D de nodos
    - nodo_generativo.py: SIMP 3D con FEA hexaedrica (integracion de Gauss verificada,
    KE con 6 modos rigidos exactos). Parametrizable por tipo de nodo (NODO_TIPO).
    - 5 nodos generativos del chasis generados como STL imprimibles:
    susp_del, susp_tras, arco_ppal, cuna_bat, pilar_a
    - exportar_visor.py + exportar_nodo_visor.py: post-procesadores 3D
    - test_ke.py: verificacion de la matriz de rigidez del elemento
    [nodo-arco_ppal.stl, nodo-cuna_bat.stl, nodo-pilar_a.stl, nodo-susp_tras.stl, nodo-suspension.stl]
2026-07-06 Ensamble 3D del chasis hibrido completo: tubos + nodos generativos
    Visor Three.js autocontenido (chasis-completo.html) con los 73 tubos del
    space frame y los 12 nodos generativos colocados en sus uniones reales
    (espejados al lado derecho). Incluye contexto de escala: ruedas de los
    QS273 en los ejes reales y pilotos de 1.75 m en posicion de manejo.
2026-07-06 Experimento: optimizacion topologica del carro entero como bloque
    Mismo SIMP de los nodos pero sobre la silueta completa del carro (2D,
    cargas y apoyos reales). Resultado: el algoritmo dibuja barras rectas en
    triangulos - un space frame. Demuestra por que tubos + nodos impresos ES
    el diseno generativo aplicado donde paga a esta escala.
2026-07-06 Inventario de huecos: que falta para construir
    Estado por sistema (hecho/parcial/falta), los 10 entregables de
    ingenieria pendientes en orden de dependencia, lo que solo se resuelve
    fuera (pedidos, terceros, taller) y las decisiones abiertas.
2026-07-06 Suspension delantera: geometria, cinematica 3D y especificacion
    Horquillas dobles sobre los anclajes reales del chasis. Solver de cuerpo
    rigido exacto (fsolve): camber -1, caster 4.9, KPI 6.1, scrub 20 mm,
    bump steer 0.04/25mm (afinado por barrido numerico de cremallera y
    mensula superior), ganancia de camber -0.49/25mm, RC +8 mm, MR 0.58.
    Spec de compra: coilover 334 mm estatico carrera 81+ mm, resorte 270
    lb/in, carga de mensula 3g = 5.7 kN. Informe y curvas en calculos/.
2026-07-07 Suspension trasera: brazo tirado con QS273, la pieza kart del carro
    3 componentes por lado: brazo PTR 70x50x4 (FS 2.4 a 3g+curva+frenado),
    pivote en nodo ta, coilover a torre coil (MR 0.68, resorte 351 lb/in,
    carrera 93 mm). Anti-squat 258% documentado: cola plantada en regen,
    cabeceo leve a fondo, ajuste previsto si molesta. Rin resuelto: QS273
    version rin de carro 14 pulgadas con 175/70R14 (en 13 no cabe).
2026-08-05 Spec de la placa de torque del QS273
    Sandwich de 2 placas de 8mm cortadas en laser que abrazan la punta del
    brazo tirado, con la mensula del caliper integrada en la placa exterior.
    Documenta por que el sandwich gana a la placa unica (el voladizo del
    motor convierte el momento de vuelco en cargas en el plano) y los 4
    casos de carga que se optimizan a la vez.
2026-08-05 Placa de torque del QS273 por optimizacion topologica
    Sandwich de 2 placas de acero 8 mm por rueda que abrazan la punta del
    brazo tirado, con la mensula del caliper integrada en la exterior.
    SIMP 2D esfuerzo plano con los 4 casos de carga resueltos a la vez
    (par por el eje, bache 3g, curva 1g, frenado 1g por el caliper).
    Tres cosas que hacen que el resultado sea real y no una demo:
    - Barrido de fraccion de volumen. La masa no es un resultado del
    optimizador, es la restriccion que se le impone; se barre y se elige
    la mas ligera que todavia da FS >= 2. 0.69 y 0.58 kg por placa.
    - Brida de la junta impuesta como superficie funcional. Minimizar
    deformacion siempre descarta apoyos redunda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
    [placa-torque-doblador.dxf, placa-torque-motor.dxf, placa-torque-refuerzo.dxf]
2026-08-05 Frenos: dimensionado completo de los 4 discos sin booster
    Reparto 57/43 elegido con el criterio de que el eje trasero NUNCA
    bloquee primero (minimo teorico 53.5% a 1g). El carro carga 62% atras
    parado pero 53% adelante frenando a 1g: un reparto pensado con el peso
    estatico trompearia.
    Dos hallazgos que cambian compras:
    - El freno del donante ATV no alcanza. La fuerza de pedal por el
    recorrido es invariante (= el trabajo que mete el pie), asi que la
    relacion de pedal y el calibre de bomba solo intercambian una cosa
    por la otra. Con disco de 180 mm ninguna combinacion cumple 450 N y
    70 mm; hay que ir a 220 mm. Por eso disco y pedalera se eligen
    acopladas, no por separado.
    - El rege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
2026-08-05 Direccion: Ackermann corregido moviendo solo la cremallera
    La geometria delantera venia afinada para camber, caster y bump steer,
    pero el Ackermann nunca se habia medido. Medido: solo +42%, corto para
    un carro que estaciona (las llantas van peleadas en maniobra lenta).
    Se resuelve moviendo la cremallera 40 mm adelante y 6 mm adentro:
    Ackermann +42% -> +87%, y el bump steer ademas MEJORA de 0.043 a
    0.028 grados/25mm. No cuesta ninguna pieza: solo donde se atornillan
    sus dos mensulas al mamparo. La altura (207 mm) no se toca.
    Metodo: al girar con la suspension quieta las rotulas no se mueven, asi
    que la mangueta solo rota alrededor del kingpin. Eso deja una incognita
    y una ecuacion, y se res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
2026-08-05 BOM maestro: cierra F0, ya se pueden pedir motores y celdas
    47 renglones con especificacion exacta de pedido, cantidad, tiempo de
    entrega y la fuente de la que sale cada numero. Sale como markdown para
    leer y como CSV con una columna precio_cotizado vacia para llenar con
    cotizaciones reales.
    Lo que se deriva solo, no se teclea:
    - El acero sale de planos/lista-corte-tubos.csv (el mismo archivo que va
    al taller), agregado por seccion y convertido a tramos de 6 m con
    merma. El precio se calcula del peso de la seccion, no a ojo.
    - El inventario de corte laser sale de los .dxf que existen en planos/,
    marcando cuales faltan por dibujar (18 listos, 10 pendientes).
    Hallazgo: el BOM detallado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
    [bom-maestro.csv]
2026-08-05 Optimizacion de secciones del chasis: 90.5 -> 81.0 kg
    Reusa la geometria, el FEM de vigas 3D y los casos de carga ya
    validados: no se movio ni un nodo, solo que tubo va en cada lugar. De
    los 73 tubos solo uno estaba al limite (FS 2.22); los otros 72 iban
    sobrados.
    Descenso codicioso por grupos funcionales sobre un catalogo de
    secciones que de verdad se consiguen, sujeto a FS >= 2 a fluencia y a
    pandeo en los 3 casos de carga, y a un piso de rigidez torsional.
    Dos decisiones que valen mas que el numero:
    - PISOS DE SEGURIDAD. La primera corrida bajaba la barra de cinturones
    a PTR 25x25x1.5, y ahi es donde tiran los arneses en un impacto. El
    FEM lo permitia porque no tiene caso de choque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
    [bom-maestro.csv, lista-corte-tubos-optimizada.csv, lista-corte-tubos.csv]
2026-08-05 Modelo 3D del carro completo: 195 piezas armables
    Junta en un solo modelo todo lo diseñado, cada pieza en sus coordenadas
    reales sacadas de su propio entregable: chasis con las secciones
    optimizadas, nodos generativos, ambas suspensiones, placas de torque,
    frenos, direccion con la cremallera en su posicion nueva, ruedas y
    motores de cubo, las 30 celdas en su cuna, cabina y pilotos de escala.
    El visor trae explorador por sistema, secuencia de armado en 7 pasos
    (deslizador que va montando el carro), vista explotada, rayos X y clic
    en cualquier pieza para ver que es, su spec y de que documento salio.
    Carroceria envolvente translucida para ubicar todo.
    HALLAZGO DEL ENSAMBLE. Armar el modelo d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
2026-08-05 Visor 3D profesional: mecanismos reales, no primitivas
    Se reescribe el visor para que cada mecanismo tenga su geometria de
    verdad en vez de una caja que lo represente: coilovers con resorte
    helicoidal, cuerpo, vastago y ojos; ruedas con perfil de llanta
    revolucionado, dibujo de banda, rin con rayos, pestanas y birlos;
    discos con campana y barrenado; calipers con pastillas y purga;
    motores de cubo con aletas; rotulas conicas, bujes de poliuretano,
    tornillos con cabeza hexagonal, butacas y arneses.
    Lo mejor: las piezas de lamina se extruyen desde SU PROPIO DXF, el
    mismo archivo que va al cortador. Las placas de torque se ven con el
    contorno que salio de la optimizacion topologica, con sus ore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
2026-08-05 Revision cruzada: 4 auditorias, 6 errores criticos corregidos
    Se lanzaron cuatro revisiones en paralelo (coherencia entre documentos,
    realismo del 3D, armabilidad e ingenieria). Encontraron errores reales
    que ningun entregable por separado podia ver. Verifique cada hallazgo
    con calculo propio antes de tocar nada.
    CORREGIDOS:
    - El FEM del chasis aplicaba 325 kg de los 564 kg suspendidos: le
    faltaba el peso propio del frame y el resto del carro. Se reparte el
    faltante por nodo en proporcion al tubo que llega. FS de bache 3g
    baja de 2.14 a 2.05, sigue cumpliendo, y la optimizacion de secciones
    sobrevive la correccion (81.0 kg con 3 secciones).
    - El aplastamiento en los planos del eje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
    [bom-maestro.csv]
2026-08-05 Cerrado el bloqueante del tie rod: geometria delantera sin interferencias
    El tie rod atravesaba el larguero inferior del chasis (la rotula de la
    cremallera quedaba DENTRO del tubo) y no habia salida moviendo la
    cremallera: de 1561 posiciones libres de interferencia, la mejor daba
    2.7 grados/25mm de bump steer contra un tope de 0.10, cien veces peor.
    La salida fue subir TODO el plano de direccion, no solo la cremallera:
    rotula de cremallera Y terminal en la mangueta pasan a y=310 mm, por
    encima del larguero. Al subir los dos extremos juntos el tie rod sigue
    el mismo arco que el brazo inferior, asi que el bump steer se conserva.
    Resultado: bump steer 0.039 grados/25mm con 46 mm de holgura, c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
    [suspension_delantera.py]
2026-08-05 Cerrados los tres bloqueantes restantes
    MENSULAS DE LA HORQUILLA INFERIOR. Los pivotes caian dentro de los
    nodos del chasis: el buje de 26 mm no cabe en un PTR de 38. Bajar el
    eje, que era lo intuitivo, invertia la ganancia de camber y mandaba el
    centro de balanceo bajo tierra (barri 35 combinaciones de altura para
    comprobarlo). La solucion es mensula de dos orejas en la cara INTERIOR
    del larguero, 30 mm hacia adentro, con el pivote superior 8 mm mas
    abajo para compensar. Camber -0.54 grados/25mm, centro de balanceo
    117 mm, bump steer 0.064, holguras.py reporta TODO LIBRE.
    De paso se corrigio el centro de balanceo, que se medía con la
    migracion del CENTRO DE RUEDA en vez del PARCHE DE CONT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
    [bom-maestro.csv, lista-corte-tubos.csv]
2026-10-10 Chasis de gaviota y carroceria v1-v2 (agosto)
    Trabajo del 2026-08-16 al 18 que se quedo sin commitear.
    CHASIS. Los rieles del techo se llevan al espinazo (z=+-0.15) para
    que el hueco de la puerta de gaviota no los cruce. Parabrisas de 44 a
    65 grados de la vertical, techo 70 mm mas abajo, celula alta en RED
    57.2x3.2 (volcadura 1.61) y PTR 38x3 en fx_hi-dash_hi (bache 3g 2.06).
    Lista de corte regenerada.
    CARROCERIA. carroceria.py construye la piel por estaciones sobre los
    puntos duros del chasis; referencias medidas (siluetas, vistas Gemini),
    firma de luces, blueprint y el visor carroceria-3d.html.
    Los binarios pesados que se regeneran (.blend, .obj, STL de 60 MB) y
    las mallas de IA de Huny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
    [lista-corte-tubos.csv]
2026-10-10 Carroceria v3: superficie de subdivision medida de la lamina
    Sustituye la malla de IA por una jaula de control de 660 caras generada
    por codigo (carro3d_jaula.py) a partir de curvas medidas en las cuatro
    vistas (curvas_ref.py), con creases en las lineas de caracter y
    subdivision en Blender (render/carro_v3.py). IoU contra la referencia:
    cenital 0.967, trasera 0.877, frontal 0.870, lateral 0.849.
    Entregables: carro-diseno-3d.html, cad/carro-v3.glb, la piel en STL
    (mm) y renders en render/salida/v3. verificar_piel_v3.py mide la piel
    contra cada tubo del chasis: el arco principal asoma 40 mm por el
    techo, queda como pendiente #0 en resultados-carroceria-v3.md.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
    [carro-v3-carroceria-mm.stl]
2026-10-10 Carroceria pulida y maqueta imprimible para la Ender 3 V3 SE
    PULIDO (revisado en acercamientos contra la lamina):
    - Pintura satinada en vez de clearcoat espejo.
    - Luces delanteras como surcos de 22 mm barridos sobre la piel con su
    normal; antes eran calcas proyectadas, anchas y mordidas en las
    esquinas de la nariz.
    - Cola: difusor como bolsillo en V real (caderas y V del triangulo en
    color carroceria), barra de tres tramos con gancho, triangulo limpio.
    - Cofre con valle de 70 mm y crease en el anillo 9: dos lomos y flecha.
    - Faldon en color carroceria, splitter suavizado y apoyado en el piso,
    rines grafito, espejos de gota.
    - bolsillo() hunde el fondo a lo largo del eje y no por la n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
    [carro-v3-carroceria-mm.stl, maqueta-1a12-arandelas-x4.stl, maqueta-1a12-carroceria-cola.stl, maqueta-1a12-carroceria-frente.stl, maqueta-1a12-ruedas-delantera-x2.stl, maqueta-1a12-ruedas-trasera-x2.stl, maqueta-1a16-arandelas-x4.stl, maqueta-1a16-carroceria.stl]
2026-10-10 Abrir el modelo y la maqueta en Blender, lado a lado
    render/abrir_en_blender.py cuelga la escena (Y-arriba) de un vacio
    girado para verla parada en Blender, e importa la maqueta 1:16 a
    tamano real (el STL viene en mm a escala). La maqueta ya no deja las
    aletas engrosadas en la escena.
2026-10-10 Tripo por API: vistas consistentes desde una foto y modelo multivista
    calculos/tripo.py usa el SDK oficial (tripo3d): generate_multiview_image
    saca frente/izquierda/atras/derecha del mismo carro a partir de la foto
    de tres cuartos, edit_multiview_image corrige una vista por texto y
    multiview_to_model arma el GLB. La clave se lee de TRIPO_API_KEY o de
    ~/.tripo_key, nunca del repo; cada tarea queda en ref/tripo/tareas.json.
    ref/tripo/ trae las imagenes de entrada en fondo blanco.
    [tripo.py]
2026-10-10 Vistas de la lamina alineadas a una escala para el multivista de Tripo
    calculos/vistas_tripo.py lleva frente, izquierda, atras y derecha a la
    misma escala usando la unica cota que comparten (piso a techo): la
    lamina las traia todas estiradas a 931 px de ancho. Sin deformar: escala
    uniforme, sombra recortada y piso en la misma fila. Convencion de Tripo
    verificada: 'left' = nariz hacia la izquierda de la imagen.
    tripo.py modelo acepta la carpeta ref/tripo/multivista.
2026-10-10 GLB y STL regenerados (misma geometria, nueva corrida de Blender)
    [carro-v3-carroceria-mm.stl]
2026-10-10 Carroceria de Tripo multivista: descarga, renders y comparacion
    Generada en Tripo Studio con las 4 vistas alineadas (H3.1 max. calidad,
    malla Ultra, textura 4K, 55 creditos). El GLB (65 MB) queda fuera de git;
    ref/tripo/LEEME.md dice de donde volver a bajarlo. render/ver_tripo.py
    lo renderiza en las vistas de la lamina; render/salida/tripo/comparacion.png
    lo pone contra la referencia.
2026-10-10 Carroceria de Tripo a escala real y juguete imprimible 1:20 / 1:64
    render/tripo_base.py lleva el GLB de Tripo a los ejes del proyecto y a
    escala por la batalla (2.130 m, eje delantero en x=0.55): 3.95 x 1.79 x
    1.11 m, via 1.50 igual que el chasis, llantas de ~740 mm. Suelda las
    costuras de UV (el glTF venia en 2184 pedazos) y lo rehace como solido
    por voxeles de 4 mm (la malla de Tripo trae 211 aristas abiertas y 189
    no manifold) -> cad/carroceria-tripo-solida-mm.stl (fuera de git).
    calculos/tripo_juguete.py: Tripo deja abiertos parabrisas, laterales,
    ventanillas y luneta con la cabina vacia detras; se cierran con cascos
    convexos por tramos de 10 cm de todo lo que esta sobre la linea de
    cin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
    [juguete-tripo-1a20.stl, juguete-tripo-1a64.stl]
2026-10-10 Abrir un STL de impresion en Blender sobre la cama de la Ender
2026-10-10 Juguete 1:20 rodante: ruedas que giran sobre ejes de filamento
    Las ruedas se separan de la carroceria de Tripo: del modelo solo se toma
    el rin (r < 228 mm, rayos y disco) porque el forro del pozo va pegado a
    la llanta y el voxel los fundio; la llanta se rehace por revolucion
    (O600 x 267). Pozos abiertos con 0.75 mm de aire a escala, ejes en gota
    de 2.1 en la carroceria y cubo de 1.85 a presion. Medidas de la llanta
    por histograma radial sobre el eje (centro y=300, rodadura ~300).
    [juguete-tripo-1a20-rodante-carroceria.stl, juguete-tripo-1a20-rodante-ruedas-x4.stl]
2026-10-10 Juguete 1:20 con puertas de gaviota que abren y ruedas que giran
    calculos/tripo_gaviota.py: la cabina queda hueca con el interior de
    Tripo y los cristales se cierran como lamina de 1.2 mm (casco por
    tramos menos el casco erosionado y prolongado al piso, sin placa en la
    cintura ni paredes entre tramos). Puertas cortadas con el contorno del
    modelo hasta el espinazo (|z|=150, el eje de bisagra del chasis real);
    la carroceria abre hasta |z|=600 y la puerta solo lleva la piel (desde
    720). Bisagra con el eje SOBRE el techo (y=1100) para que al abrir la
    piel gire hacia afuera; nudillos de carroceria adelante y atras, de la
    puerta al centro, pasador de filamento de 17 mm. Las ruedas son las del
    roda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
    [gaviota-1a20-carroceria.stl, gaviota-1a20-puerta-der.stl, gaviota-1a20-puerta-izq.stl, gaviota-1a20-ruedas-x4.stl]
2026-10-10 Cristales sin arrugas y bisagra de gaviota oculta en el techo
    cerrar_aberturas(): en vez de envolver todo el invernadero (los cascos
    se tendian sobre la curva de detras de la ventanita y la llenaban de
    facetas), por cortes cada 2 mm se detectan solo las aberturas reales:
    entradas de mas de 2 dm2 entre el contorno y su envolvente (ventanas
    23-37, luneta 4-14, base del parabrisas 4-6; la curva del diseno no
    pasa de 1.4). La superficie sale de cascos 3D por tramos de 6 cm
    (lisa) y solo se aplica dentro de esas zonas. El parabrisas, que Tripo
    dejo ondulado, se cubre entero. Para la lamina, el casco se erosiona
    con un disco en (y,z) para no dejar costillas en la cabina.
    Bisagra oculta: eje a 106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
    [gaviota-1a20-carroceria.stl, gaviota-1a20-puerta-der.stl, gaviota-1a20-puerta-izq.stl, juguete-tripo-1a20-rodante-carroceria.stl, juguete-tripo-1a20.stl, juguete-tripo-1a64.stl]
2026-10-10 Cristal sin aletas en la cadera, hundido en su marco y puerta de contorno curvo
    - Solo se cierran entradas que cruzan el centro del carro; detras de las
    ventanas laterales solo la luneta (|z|<450) y con apertura morfologica
    de 20 mm: la entrada de la luneta se unia a la curva de la cadera en
    cortes sueltos y dejaba aletas de cristal como peine.
    - El cristal va 4 mm por dentro de la envolvente (disco en y,z): sobresalia
    del marco como placa con orilla escalonada.
    - Contorno de la puerta redondeado (Chaikin x3): con 12 puntos la curva
    trasera salia en tramos rectos en el marco de la carroceria.
    choques() sigue en 0 de 15 a 65 grados.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
    [gaviota-1a20-carroceria.stl, gaviota-1a20-puerta-der.stl, gaviota-1a20-puerta-izq.stl, juguete-tripo-1a20-rodante-carroceria.stl, juguete-tripo-1a20.stl, juguete-tripo-1a64.stl]
2026-10-10 Perfil de impresora separado del diseno: juguete de gaviota para la Ender 3 V3 SE
    calculos/impresora.py + impresion/impresoras/ender3v3se.json (de
    impresora3d.md): brim de 5 mm (pieza max. 206 mm), agujeros +0.1 mm por
    el flujo 1.05 y holgura de puerta 0.4 por los bordes abultados. Los
    generadores aceptan --impresora y escriben en impresion/<nombre>/; sin
    ella siguen con las medidas de diseno en impresion/. La version Ender
    sale en dos placas (carroceria; puertas y ruedas) con su LEEME de
    laminado para los perfiles OrcaSlicer de la PC con Linux.
    [gaviota-1a20-placa1-carroceria.stl, gaviota-1a20-placa2-puertas-y-ruedas.stl, prueba-tolerancias-ejes.stl]
2026-10-10 Ender 3 V3 SE: agujeros medidos con la regla de prueba (2.1 presion, 2.3 libre)
    El perfil guarda diametros absolutos (agujeros_mm) en lugar de una
    compensacion estimada: la prueba dio que 2.0 no entra, 2.1 queda firme y
    2.2 con roce leve. impresora.agujero() usa el medido si existe y si no
    el de diseno + compensacion. El diseno base no cambia.
    [gaviota-1a20-placa1-carroceria.stl, gaviota-1a20-placa2-puertas-y-ruedas.stl]
2026-10-12 Maqueta de asiento: cuerpo real de 1.75 m, metricas de cabina, spec y plan de cabina y puertas
2026-10-12 Puertas de gaviota: cinematica, amortiguador de catalogo, carga LC7 y herraje
2026-10-12 Chasis rediseñado: puerta libre, piloto real de 1.75 m sobre rieles, bisagras, amortiguador y caso LC7
    - rediseno_chasis.py + fem_chasis.py: estructura de tierra con volumenes prohibidos (hueco de puerta,
    cuerpo del piloto en 3 posiciones del riel, bateria, parabrisas, plano del arco)
    - travesaños de asiento en x=1.36 y 1.66, barra de cinturones a la altura del hombro, cabecera +15 mm
    - tramos de un mismo tubo comparten seccion; la lista de corte fusiona los nodos virtuales de bisagra
    - resultado: 90 miembros, 85.8 kg, K 8,037, LC1 2.65 LC5 1.53 LC5c 1.65 LC6 2.23 LC7 29
    [lista-corte-tubos.csv]
2026-10-12 Visor con piloto, puertas que abren y herraje; eje de bisagra a la altura de la puerta, bisagras flanqueando su centro de masa
    - puertas.py: eje horizontal a y=1.06 (el de las piezas de la puerta), bisagras en x=1.55 y 1.85,
    reaccion en el perno con el momento de excentricidad al nodo del riel; LC7 con 6 componentes
    - chasis: 89 miembros, 83.8 kg, K 8,022, LC1 2.82 LC5 1.52 LC5c 1.66 LC6 2.06 LC7 26.9
    - visor: maniqui de 1.75 m, puertas de cad/_gaviota-1a20 a escala real, vistas de ojos
    [lista-corte-tubos.csv]
2026-10-12 Herraje de las puertas, lista de compra y paleta de 6 secciones de tubo
    - docs/herraje-puertas.md: construccion, herraje con coordenadas, armado 'encaje sobre el carro', criterios medidos
    - bom.py: filas de bisagras, amortiguadores 350 N, cierres, policarbonato, sello, fibra, rieles, tubo Ø16 y placa 3 mm
    - rediseno_chasis.py: paleta de 6 secciones por defecto (87.3 kg; 83.8 kg con 9, 91.2 kg con 5)
    - chasis: 89 miembros, 87.3 kg, K 8,706, LC1 3.03 LC5 1.52 LC5c 1.72 LC6 2.09 LC7 28.6
    [bom-maestro.csv, lista-corte-tubos.csv]
2026-10-12 Correcciones de las auditorias: arnes 10 g (LC8), LC7 en equilibrio, amortiguador libre del pilar A, eje de bisagra inclinado, arco reforzado
    - LC8: choque frontal a 10 g con arnes (5.3 kN por asiento); patas del arco y barra de cinturones en RED 57.2x3.2
    - LC7 en equilibrio con el amortiguador a tope; puerta de diseño de 12 kg -> amortiguador 500 N; ancla libre del pilar A
    - eje de bisagra inclinado siguiendo el techo (el perno delantero asomaba 5 mm); punto mas bajo de la puerta abierta medido: 1.26 m
    - volcadura con piso 1.65; metrica de cabecera con el radio real del tubo (+12.9 grados)
    - chasis: 91 miembros, 83 tubos de corte, 90.1 kg, K 8,702; docs y BOM regenerados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
    [bom-maestro.csv, lista-corte-tubos.csv]
2026-10-12 Cierre de sesion: docs/ESTADO.md (como ver el 3D, verificar, retomar) y preparar_piel_tripo.py para regenerar la piel sin depender de la carpeta temporal
2026-10-22 Cargas de suspension reales, bateria en tunel, cabina, espacios y seguridad de puertas
    - cargas_suspension.py / reforzar_suspension.py: FEM con cargas de suspension
    (S1-S6 + axiales), von Mises y pandeo con signo, criterio en dos niveles
    - masas_modelo/masas_cg: tabla de masas explicita; bateria de 30 celdas en el
    tunel central, CG 0.40 m, 46.7% delante; cascada a resortes, frenos y BOM
    - holguras.py: distancia segmento-segmento (Ericson) y brazos/amortiguador vs chasis
    - Chasis 99.0 kg, K 9748 N.m/grado, 7 secciones, 29 pruebas verdes
    - Cabina: mandos, auditoria, buck del piloto; espacios libres (frunk 36 L,
    bandeja 45 L, maletero 175 L); seguridad de puertas (viga de impacto, pasador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
    [bom-maestro.csv, lista-corte-tubos.csv]
2026-10-26 Eliminar HTML 3D obsoletos e ignorar el zip del slicer
